aidinattar/RelazioneCatenaElettronica/relazione.pdf

# Catena elettronica

Docente: dott. Garfagnini, dott. Lunardon Gruppo 14

Anno accademico 2019/20

- Aidin Attar - 1170698 - aidin.attar@studenti.unipd.it
- Ema Baci - 1171107 – ema.baci@studenti.unipd.it
- Alessandro Bianchetti – 1162147 – alessandro.bianchetti@studenti.unipd.it

SCOPO DELL’ESPERIENZA: STUDIO DELLA CATENA ELETTRONICA COME MODELLO DI RI-VELATORE PER RADIAZIONE IONIZZANTE

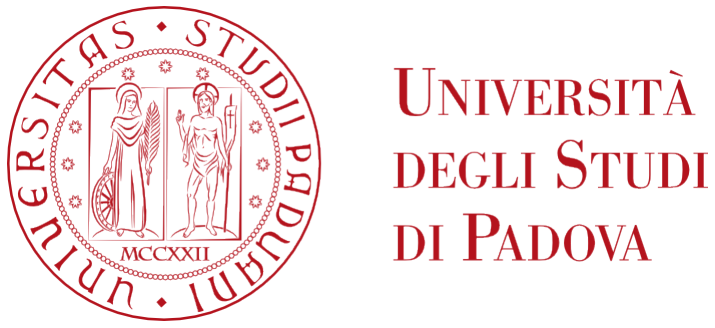
[picture p2: figure]

Descrizione dell’apparato

La seguente esperienza è stata svolta sul banco di lavoro 1. L’apparato di misura consiste di un oscilloscopio digitale Tektronix TBS 1102B EDU, un generatore di funzioni Tektronix AFG 1022, un alimentatore di tensione continua stabilizzato, due multimetri digitali (Metrix 32292 e Agilent U1230) e una scheda Arduino Due. Si è inoltre fatto uso di due integrati TL082C contenenti in tutto 4 amplificatori operazionali.
I circuiti studiati sono stati costruiti sulla basetta millefori alimentando gli amplificatori operazionali come nello schema riportato in Figura 1
I valori misurati di resistenze e capacità utilizzate verranno riportati in seguito, mentre la procedura per identificare le incertezze è descritta in appendice.
Infine si è fatto uso di due sonde con fattore di attenuazione 10x precedentemente compensate per la visualizzazione del segnale nei due canali dell’oscilloscopio.
Per l’analisi dati sono stati utilizzati programmi scritti in c++, root ed Excel.

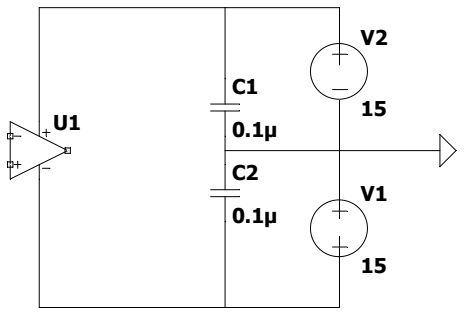
[picture p3: figure]

Figura 1: schema per l’alimentazione dell’operazionale

## 1 Preamplificatore di carica

### 1.1 Breve discussione del circuito

Lo scopo dell’esperienza completa è costruire un circuito che possa rilevare piccoli segnali, amplificarli tanto da poterli processare con più facilità e poi amplificarli ulteriormente per offrirli allo sperimentatore. Il primo passo della realizzazione di tale catena elettronica è il circuito preamplificatore. Qui il generatore di funzioni è utilizzato proprio per simulare piccoli segnali di cui sopra analoghi a quelli che proverrebbero tipicamente da esperienze di spettrocopia: si forniscono dunque in ingresso impulsi di tensione (PULSE) come quelli che produrrebbe il passaggio di una radiazione ionizzante in un volume di gas. Si è dunque costruito il circuito come in Figura 2

La funzione di trasferimento è data, nel formalismo di Laplace, da

H(s) = −

Rpre

Rin

1

1 + sRpreCpre

(1)

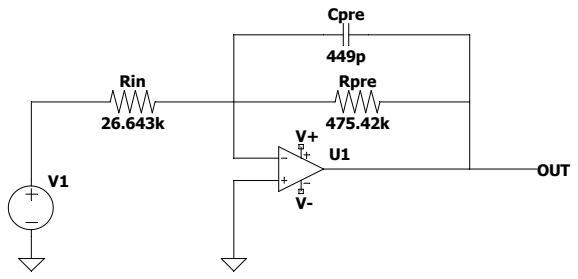
[picture p4: figure]
Cpre; 449p Rpre; Rin; OUT

Figura 2: circuito amplificatore di carica

in cui possiamo effettuare la sostituzione s ←→ iω per riprodurre la soluzione stazionaria. Considerando poi solamente il modulo, e definendo il tempo caratteristico τpre = RpreCpre, avremo

H(ω) = Rpre

Rin

1
q
1 + ω²τ

2
pre

(2)

Si osserva inoltre che inserendo nella formula 1 la trasformata di Laplace dell’impulso di tensione, pari a Vin/s, si otterrà in uscita, antitrasformando opportunamente, un segnale esponenziale corrispondente a

V

pulse
pre (t) = −

Rpre

Rin

Vin(1 − e

− t
τpre ) | (3)

Quest’ultima è valida finché dura l’impulso di tensione: essendo Tpulse << τpre, potremo considerare l’espansione in serie di Taylor della 3, ottenendo una discesa lineare. Tale discesa lineare si interromperà all’esaurirsi dell’ impulso in ingresso, lasciando posto alla formula della scarica del condensatore Cpre, caricato proprio dallo stesso impulso. Ne risulta un grafico che ha un picco negativo V

max
pre in
corrispondenza di t = Tpulse, per poi risalire con la curva esponenziale dettata da

V

RC
pre (t) = V

max
pre e

− t
τpre . | (4)

### 1.2 Discussione dati

Si precisa che sono stati suggeriti dei valori per i parametri del circuito τpre,th = 220µs e Cpre = 450 pF, con Rpre calcolato di conseguenza. Pertanto i valori misurati con il multimetro Metrix 32292 sono

Rpre = (475.4 ± 0.2)kΩ σ% = 0.04%
Cpre = (149 ± 14)pF σ% = 3.1% τpre,th = (213 ± 7)µs σ% = 3.1%

Si è dunque impostato un impulso della durata di Tpulse = 2µs: sapendo inoltre che la carica da iniettare corrispondeva a Qth
in = 80 pC e che la resistenza di ingresso scelta misurava Rin = (26.64 ± 0.01) kΩ (σ% = 0.04%), si è selezionata l’altezza Vin dell’impulso in modo che fosse soddisfatta la relazione
Qin =

Vin

Rin

Tpulse. | (5)

Ne si è ricavato V

th
in = 1.06V. Per controllare la correttezza del circuito si è misurato il picco V

max
pre , dato, utilizzando
l’approssimazione della 3, da

V

max
pre = −

Rpre

Rin

Vin

Tpulse

τpre

= −

Qin

Cpre

(6)

da cui, inserendo il valore misurato V

th
in = (1.02 ± 0.02)V,
si ricava V

max
pre,th = (−170±6)mV. Invece dalla misura si ottiene V

max
pre,sper = (−176±4)mV, per cui λ = 0.76 e lo scostamento percentuale è = 3.2%, ossia il valore misurato è ottimamente compatibile con quello atteso.
Si è inoltre la verificata la linearità tra Qin e V

max
pre de-
scritta da 6 variando la durata dell’impulso in ingresso e quindi la carica iniettata nel circuito secondo 5. Si riportano quindi in grafico i punti, la retta interpolante e i principali

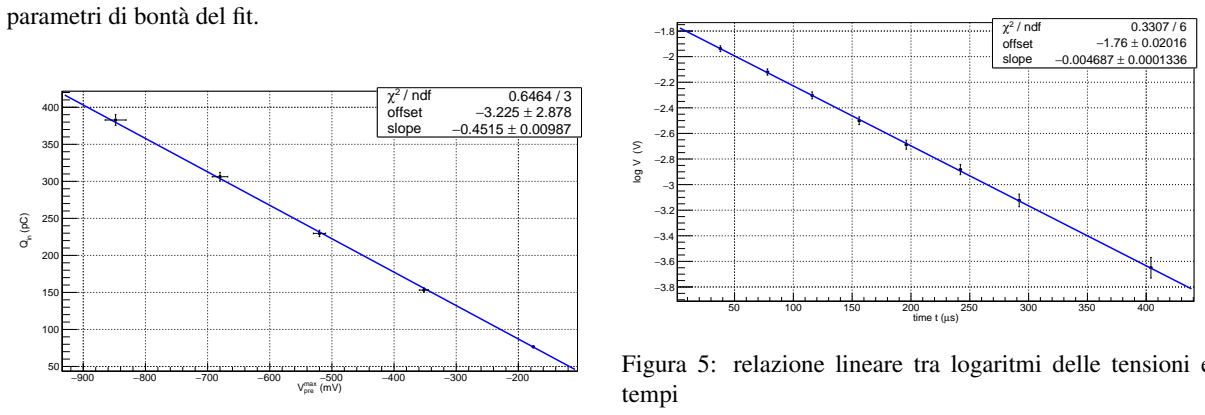
[picture p5: figure]
parametri di bontà del fit.; (mV) max Vpre; time t (µs); log V (V); tempi

| / ndf ² χ / ndf ² χ | 0.6464 / 3 0.6464 / 3
offset offset slope slope | | −3.225 ± 2.878 −3.225 ± 2.878 −0.4515 ± 0.00987 −0.4515 ± 0.00987

Figura 3: carica iniettata e picco di tensione in uscita

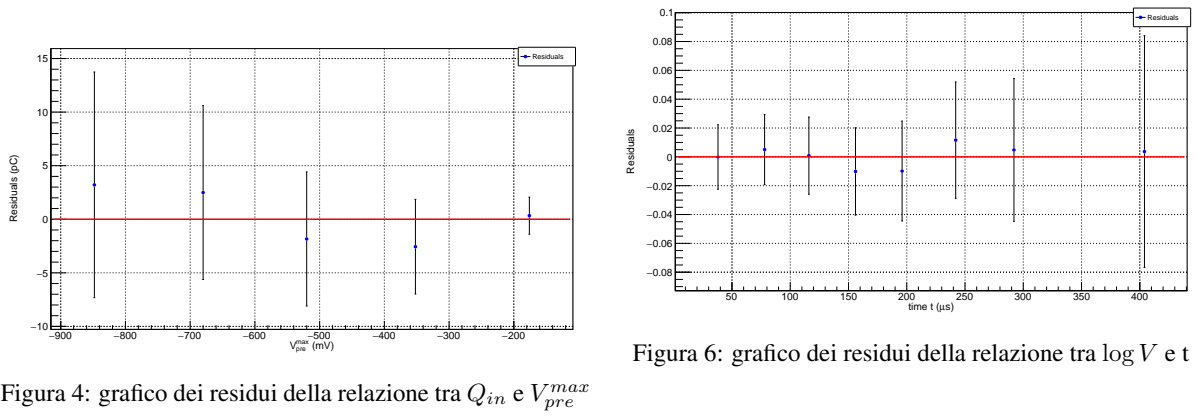
[picture p6: figure]
(mV) max Vpre; Residuals (pC); Residuals; max pre; time t (µs)

Figura 4: grafico dei residui della relazione tra Qin e V

σy,post | χ
| (2) | λχ | ρ | t
3.0 pC | 0.65 | 0.96 | -0.9998 | -109.14

Tabella 1: parametri di verifica della bontà del fit

Si specifica che il fit è stato effettuato utilizzando gli errori di entrambe le coordinate, poichè nessuno dei due errori relativi è risultato trascurabile rispetto all’altro. Gli estimatori danno tutti risposta positiva, quindi possiamo concludere che la relazione lineare è ben verificata. Inoltre dal valore di pendenza, considerando la legge lineare 6, è possibile ottenere una stima sperimentale della capacità

Cpre, da confrontare con il valore misurato. Si ricava quindi Cpre,sper = (452 ± 10)pF, che ha λ = 0.15 rispetto al valore misurato.
Inoltre dallo studio della 4, e in particolare della sua linearizzazione logaritmica, è possibile ricavare una stima sperimentale di τpre. Infatti applicando il logaritmo naturale si ottiene

log V (t) = log V

max
pre −

t

τpre

(7)

per cui si trova una relazione lineare tra log V (t) e t, da cui τpre=-1/b con b slope del fit. Si riporta il grafico di tempi e logaritmi delle tensioni, interpolati linearmente, e il relativo grafico dei residui

/ ndf ² χ / ndf ² χ | | 0.3307 / 6 0.3307 / 6
offset offset | | −1.76 ± 0.02016 −1.76 ± 0.02016
slope slope | −0.004687 ± 0.0001336 −0.004687 ± 0.0001336

Figura 5: relazione lineare tra logaritmi delle tensioni e

Figura 6: grafico dei residui della relazione tra log V e t

σy,post | χ
| (2) | λχ | ρ | t
0.008 V | 0.33 | 1.64 | -0.99991 | -189.59

Tabella 2: parametri di verifica della bontà del fit

Si osserva la buona riuscita del fit, che verifica la scarica RC del circuito al termine dell’impulso. Tuttavia è possibile notare una forte sovrastima degli errori sia visivamente osservando il grafico dei residui in Figura 6, sia osservando il valore molto basso di χ

| | (2)
Dal valore della pendenza, come anticipato prima, ricaviamo una stima di τ
| | sper
pre . A scopo di controllo, è inoltre possibile ottenere una valutazione di V
| | | | max
pre | usando il
parametro di offset a sapendo V
| | | max
pre | = e

a
| | | | . Si riportano

quindi i due valori calcolati con i loro errori calcolati per propagazione.

τ

sper
pre = (213 ± 6)µs σ% = 2.9%

V

max
pre = (−172 ± 3)mV σ% = 2.0%

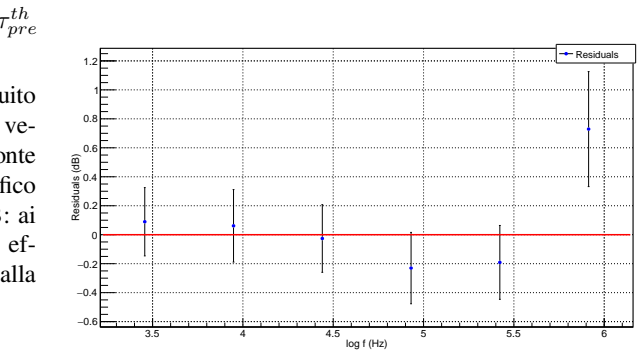
[picture p7: figure]
th pre; log f (Hz); Residuals (dB)

che risultano ottimamente compatibili con i valori attesi τ e V

max
pre,th, in quanto λτ = 0.01 e λV = 0.2.

Si è infine effettuato uno studio in frequenza del circuito con lo scopo di verificare la 2, variando la frequenza e verificando il variare del modulo dell’amplificazione di fronte a un ingresso sinusoidale. Si riporta in particolare il grafico di Bode che raffigura frequenza e amplificazione in dB: ai punti sperimentali si è affiancata anche la simulazione effettuata su LTspice e il modello teorico rappresentato dalla 2.

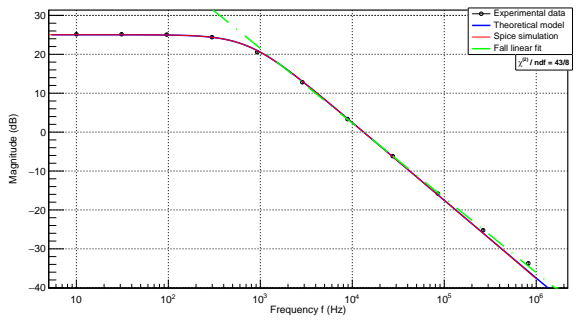
[picture p8: figure]
Frequency f (Hz); Magnitude (dB); / ndf = 43/8 ⁽²⁾ χ

Experimental data Theoretical model Spice simulation Fall linear fit

Figura 7: grafico di Bode del circuito preamplificatore

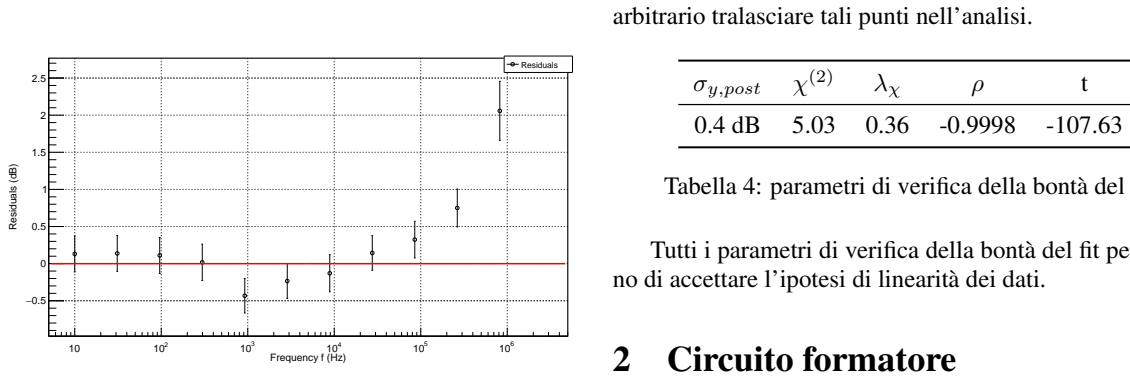
[picture p9: figure]
Frequency f (Hz); Residuals (dB); Residuals; arbitrario tralasciare tali punti nell’analisi.; σy,post; 2 Circuito formatore

Figura 8: residui del grafico di Bode

Si osserva che i dati sono rappresentati ottimamente dal modello teorico per basse frequenze, mentre per alte frequenze tendono a discostarsi, anche in modo significativo da esso. Si osserva quindi un valore di χ

(2) ≈ 43 del tutto
incompatibile con il suo valore di aspettazione (gdl = 8). La natura di tali problematiche è da ricercarsi in effetti trascurati, quali capacità parassite della breadboard utilizzata o altri fenomeni che causano la non idealità dell’esperimento.
Come si può notare in Figura 7 si è effettuato anche un fit lineare della discesa, per verificare che la slope sia effettivamente compatibile con il valore atteso di −20dB/decade. Si ottengono dunque i seguenti parametri di interpolazione:
| a±σa | b±σb
| (dB) | (dB/decade)
discesa | 79.1±0.6 | -19.2±0.1

Tabella 3: parametri di interpolazione lineare della discesa

Residuals Figura 9: residui dell’interpolazione lineare della discesa

Si nota che il valore di slope non è di fatto compatibile con il valore atteso: questa problematica potrebbe essere dovuta a una sottostima degli errori. In alternativa, è possibile che gli ultimi dati possano avere qualche bias: infatti escludendo questi punti dal fit si ottiene un valore di pendenza compatibile con il valore di aspettazione. Si evita tuttavia di scartare dati: si otterrebbe un set eccessivamente ristretto e soprattutto non si conosce la natura di questo bias (potrebbe essere dovuto, come già detto, a capacità parassite non considerate nello studio), sarebbe quindi del tutto

Tabella 4: parametri di verifica della bontà del fit

Tutti i parametri di verifica della bontà del fit permettono di accettare l’ipotesi di linearità dei dati.

### 2.1 Shaper base CR-RC

### 2.1.1 Breve discussione del circuito

Il secondo passo per la costruzione della catena elettronica consiste invece nella costruzione del circuito formatore il cui schema è riportato in Figura 10, che plasmi il segnale fornendo tipicamente un profilo gaussiano.

Si osserva che il circuito è costruito tramite due stadi RC e CR, disaccoppiati tramite un buffer costruito utilizzando il secondo opamp presente nel TL082.
Si specifica inoltre che i valori di C

(1)
sh ≈ C

(2)
sh e R

(1)
sh ≈
R

(2)
sh sono stati scelti in modo da ottenere il valore di τsh indicato nel logbook. Tuttavia, a causa di un cambio di

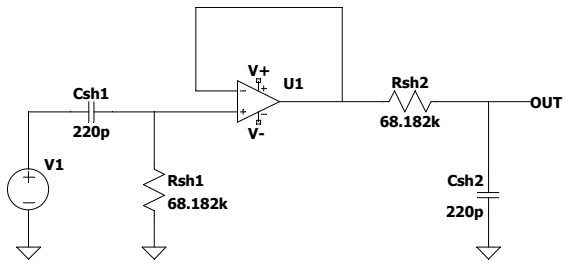
[picture p10: figure]
Csh1; Csh2; Rsh1 68.182k; Rsh2; OUT

Figura 10: circuito formatore

combinazione in corso d’opera per problemi sorti durante la prima giornata di esperienza, τsh e Csh con cui si è lavorato sono sì quelli della nuova combinazione, ma le altre grandezze in gioco sono rimaste quelle della combinazione originale (Cpre,th = 330 pF, τpre = 220 µs). Si è utilizzata quindi una capacità di 220 pF e una costante di tempo caratteristica τsh di 15 µs che in realtà non sono associati ai parametri usati del preamplificatore in nessuna combinazione.
Trattando il circuito con Laplace e considerando la fase stazionaria, si ottiene che la funzione di trasferimento in funzione di ω è la seguente:

H(ω) = ωτ
1 + ω²τ

2

(8)

In particolare, inserendo in ingresso un’onda quadra tra 0 e V0 si ottiene la funzione Vout(t) facendo l’antitrasformata dal dominio delle frequenze:

Vout(t) = −

V0
τ

t · e

− t
τ | (9)

### 2.1.2 Discussione dei dati

Si è nuovamente impostata sul generatore di funzioni un’onda quadra di frequenza di 100 Hz e ampiezza misurata pari a V0 = (992 ± 15)mV in modo che simuli il comportamento di un preamplificatore ideale che mantenga il segnale alto per un tempo indefinito.
Sapendo che τth = R

(1)
sh C

(1)
sh = R

(2)
sh C

(2)
sh = 15µs si
sono scelti e misurati i seguenti valori:

R

(1)
sh = (68.31 ± 0.03)kΩ σ% = 0.04%

R

(2)
sh = (68.075 ± 0.03)kΩ σ% = 0.04%

C

(1)
sh = (234 ± 9)pF σ% = 4%

C

(2)
sh = (234 ± 9)pF σ% = 4%

dove l’errore è stato calcolato secondo quanto scritto in appendice.
Mediante i cursori si è quindi misurato il valore massimo (in valore assoluto) V

max
sh = (346 ± 6)mV e il tempo corrispondente τ

max
sh = (16 ± 1)µ s.
Si è poi verificata la correttezza del trasferimento immettendo nel circuito un’onda quadra di ampiezza 1V e misurando un set di 10 punti della curva in uscita, indicata dal modello in 9. In particolare però per l’identificazione della curva teorica si è scelto di non utilizzare il τ

sper
sh ma bensì di
sfruttarlo come parametro per applicare il metodo del minimo χ

(2), ossia vagliare i valori del χ

(2) rispetto ai dati sperimentali al variare di τsh e quindi della curva teorica e poi scegliere il tempo caratteristico per cui l’estimatore risulta avere un minimo. La scelta del minimo è stata effettuata tramite un fit parabolico in prossimità della convessità, e calcolando l’ascissa del vertice della parabola. L’errore di τsh è dato dalla semidispersione ottenuta facendo riferimento all’intervallo [τ+; τ−] tali per cui χ

(2)
± = χ

(2)
min + 1.

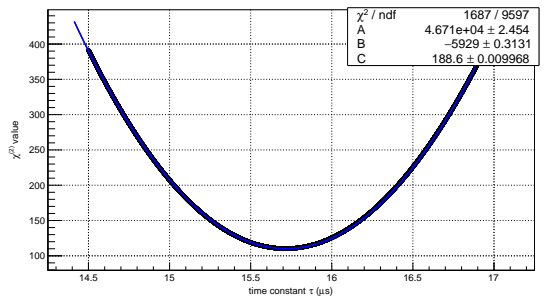
[picture p11: figure]
time constant τ (µs); value (2)

/ ndf ² χ / ndf ² χ A A B B | 1687 / 9597 1687 / 9597 4.671e+04 ± 2.454 4.671e+04 ± 2.454 −5929 ± 0.3131 −5929 ± 0.3131
C | 188.6 ± 0.009968 Figura 11: andamento di χ
(2) al variare di τsh

Da cui si sceglie τsh = (15.72 ± 0.07)µs. Tuttavia si osserva che il valore di χ

(2) ≈ 110 corrispondente è tutt’altro che confortante considerando il numero limitato di gradi di libertà. I grafici seguenti mostrano tale problematica:

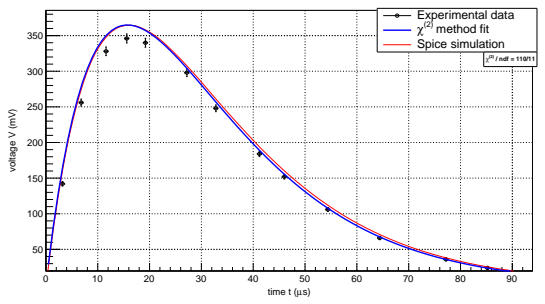
[picture p12: figure]
time t (µs); voltage V (mV); Spice simulation; / ndf = 110/11 ⁽²⁾ χ

| Experimental data method fit ⁽²⁾ χ

Figura 12: risposta del circuito formatore a un’onda quadrata in ingresso

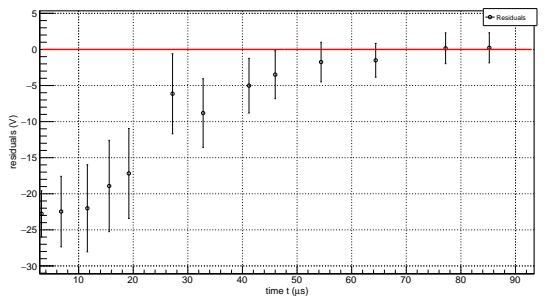
[picture p13: figure]
time t (µs); residuals (V); Residuals

Figura 13: residui della risposta dello shaper a un’onda quadra

Si nota che i dati non sono compatibili con il modello teorico, in quanto pur riproducendone l’andamento risultano sensibilmente staccati, in particolare in prossimità del picco. La forma 9 ha massimo in V0/e, ossia il picco è proporzionale all’altezza dell’impulso inserito, per cui si dovrebbe avere V

max
sh,th = (365 ± 5)mV , mentre si è misurato V

max
sh = (346 ± 6)mV . La compatibilità è λ = 2.3, accettabile, ma comunque pessima. Da una parte abbiamo quindi il cattivo χ
| (2), dall’altra una compatibilità accettabile tra i
due picchi: si potrebbe dunque sospettare una certa sottostima degli errori, che però non sembra sufficiente a spiegare un tale distacco dei dati dal modello, che sembrerebbe sistematico, in quanto i dati tendono a rimanere sempre al di sotto della curva teorica.
| Come anticipato, il valore di χ
(2) ottenuto porta a dover rifiutare il fit. Dal grafico dei residui si osserva la tendenza per la quale ai tempi iniziali la curva risulta completamente inadatta, mentre sulla coda descrive bene i dati.
| Osservando anche la curva ottenuta dalla simulazione
spice si nota che essa risulta molto fedele alla curva ottenuta con il fit, quindi il problema sembrerebbe essere sui dati.
| Tale problematica potrebbe essere riconducibile ad un
errore umano, dovuto a impostazioni sbagliate nell’onda in ingresso, come ad esempio l’ampiezza dell’onda, o in alternativa a qualche bias dovuta ancora alla non idealità del circuito.
| Si è infine nuovamente studiato il comportamento del
circuito al variare della frequenza. Si è ottenuto il seguente grafico di Bode (Figura 14), al fine di ottenere un confronto immediato sono plottate sovrapposte la curva teorica relativa ai dati sperimentali ed il fit dei dati ottenuti mediante la simulazione di LTspice:

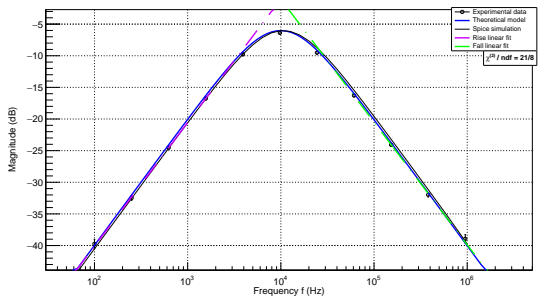
[picture p14: figure]
Frequency f (Hz); Magnitude (dB); Experimental data Theoretical model; / ndf = 21/8 ⁽²⁾ χ

| Spice simulation Rise linear fit Fall linear fit
Figura 14: grafico di Bode del circuito formatore 10 | 2 10 | 3 10 | 4 10 | 5 10 | 6 10

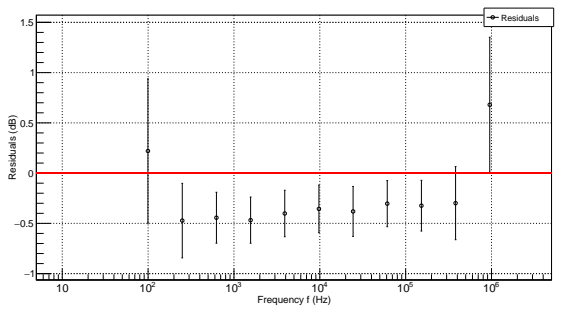
[picture p15: figure]
Frequency f (Hz); Residuals (dB); Residuals

Figura 15: residui del grafico di Bode

Si osserva il diverso comportamento dello shaper base, che opera come derivatore per frequenze basse e come integratore a frequenze alte.
Il valore di χ
(2) risulta compatibile con il suo valore di aspettazione, in accordo con la Tabella 14. Tuttavia si nota in Figura 15 una certa sistematicità: la curva tende a rimanere sempre sopra ai dati.
Come si osserva in Figura 14 si sono effettuati i fit della salita e della discesa, per la verifica della consistenza delle pendenze.
| a±σa | b±σb
| (dB) | (dB/decade)
salita | -79±1 | 19.5±0.4
discesa | 77±2 | -19.4±0.4

Tabella 5: parametri di interpolazione della salita e della discesa

4.8 | 5 | 5.2 | 5.4 | 5.6 | 5.8 | 6
| | | log f (Hz)

−0.6

−0.4

−0.2

0

0.2

0.4

0.6

0.8

1

1.2

Residuals (dB)

Residuals

(a) Residui fit della discesa
2 | 2.2 | 2.4 | 2.6 | 2.8 | 3 | 3.2
| | | log f (Hz)

−0.6

−0.4

−0.2

0

0.2

0.4

0.6

0.8

1

1.2

Residuals (dB)

Residuals

(b) Residui fit della salita

Figura 16: residui per i fit lineari dello shaper

| σy,post | χ
| | (2) | λχ | ρ | t
discesa | 0.4 dB | 1.01 | 0.49 | -0.9996 | -51.23
salita | 0.3 dB | 0.44 | 0.78 | 0.9998 | 76.28

Tabella 6: parametri di verifica della bontà del fit

Si osserva che i valori di slope osservati sono compatibili con i valori attesi e i parametri di verifica della bontà del fit permettono tutti di accettare l’ipotesi di andamento lineare.

### 2.2 Shaper compensato

### 2.2.1 Breve discussione del circuito

Si è proceduto inserendo come segnale in ingresso dello shaper il segnale di uscita del preamplificatore. Subentra quindi il problema di dover compensare l’effetto del pole-zero: infatti, se si considera in ingresso un segnale del tipo

Vin(t) = V0e

| | | − t
τpre

si ottiene la seguente trasformata di Laplace:

Vin(s) = | V o
| | | s +

1

| | | τpre | | (10)

che presenta un polo in −

| | 1 τpre
, responsabile dell’undershoot del segnale.
Si osserva però che il segnale in uscita dal primo stadio (CR) del formatore con una tensione in ingresso a gradino è descritto dalla seguente formula: Vout(s)
| | | | CR = | V0 s+ 1 τsh
; si

vuole quindi modificare il circuito in modo che all’ingresso del buffer arrivi un segnale che segua questo stesso andamento. Si è quindi inserita una resistenza Rpz in parallelo

a C

(1)
sh e si è studiato l’andamento di Vout(s)

CR di questo
nuovo circuito mediante la trasformata di Laplace:

Vout(s)

CR =

V0
s +

1
τpre

·

s +

1
τpz
s +

1
τk

(11)

dove τpz = C

(1)
sh Rpz, τk = C

(1)
sh Rk e Rk è il parallelo di R

(1)
sh e Rpz; l’effetto del polo del preamplificatore è quindi annullato con quello dello zero del CR compensato nel caso in cui τsh = τpz . Regolando quindi opportunamente tale valore si compensa l’effetto pole-zero; si è quindi scelto

Rpz =

τpre

C

(1)
sh
Si riporta quindi di seguito lo schema del circuito dello shaper compensato:

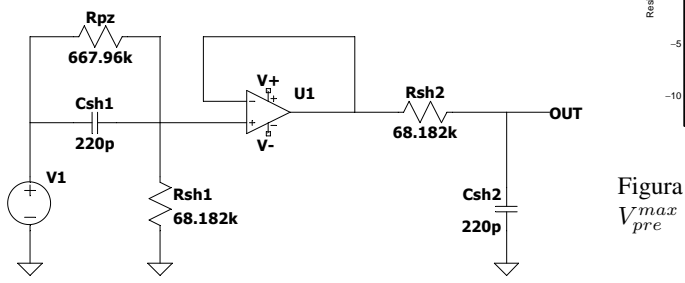
[picture p16: figure]
Csh1; Csh2; Rsh1 68.182k; Rsh2; Rpz; OUT; max pre

Figura 17: circuito formatore con compensazione

dove V1 è il segnale in uscita dal preamplificatore. Studiando infine la funzione di trasferimento dell’intero circuito mediante la trasformata di Laplace e passando al dominio delle frequenze con la sostituzione s −→ iω si ottiene:

|H(ω)| =

### vuut

1
1 + (ωτ )

2

·

(R

(1)
sh )

2 + (Rpzωτ )

2
(R

(1)
sh + Rpz)

2 + (Rpzωτ )

2
(12)

### 2.2.2 Discussione dei dati

Si è osservato che senza utilizzare lo shaper base per un segnale esponenziale come quello fornito dal preamplificatore si ottiene il fenomeno dell’undershoot: infatti unendo preamplificatore e shaper si è misurato Vsh,undershoot = (346 ± 6)mV (l’undershoot è positivo poichè il segnale è ribaltato a causa della natura invertente del preamplificatore). Inserendo invece la resistenza Rpz = (668.0 ± 3)kΩ si vede che l’effetto di undershoot sparisce e il segnale si adagia correttamente sullo zero delle tensioni.
Con il circuito correttamente compensato, si è verificato che la relazione tra carica iniettata e tensione in uscita fosse lineare, variando la durata dell’impulso in ingresso e acquisendo i picchi delle forme d’onda semigaussiane in uscita dallo shaper.

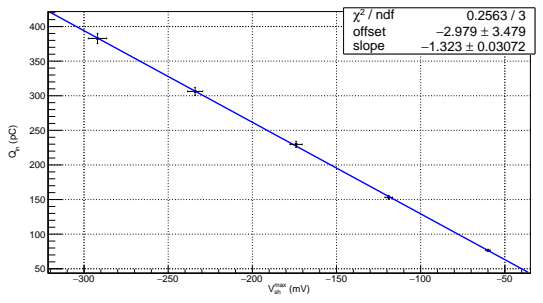
[picture p17: figure]
(mV) max Vsh

/ ndf ² χ / ndf ² χ | 0.2563 / 3 0.2563 / 3
offset offset slope slope | −2.979 ± 3.479 −2.979 ± 3.479 −1.323 ± 0.03072 −1.323 ± 0.03072

Figura 18: carica iniettata e picco di tensione in uscita

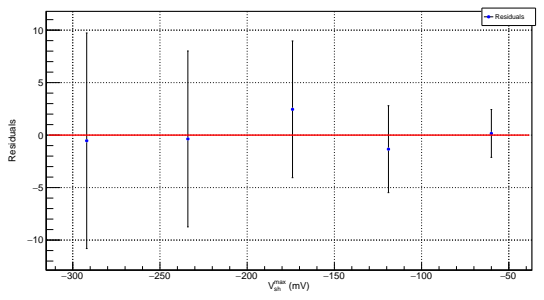
[picture p18: figure]
(mV) max Vsh; Residuals

Figura 19: grafico dei residui della relazione tra Qin e

σy,post | χ
| (2) | λχ | ρ | t
1.7 V | 0.26 | 1.12 | -0.99993 | -146.28

Tabella 7: parametri di verifica della bontà del fit

I parametri confermano la buona riuscita del fit lineare e dunque costituiscono la prova della relazione lineare che intercorre tra carica iniettata e uscita dello shaper.

## 3 Circuito amplificatore invertente

### 3.1 Descrizione del circuito

Unendo il circuto preamplificatore con il circuito formatore otteniamo un segnale correttamente processato ma negativo e dunque non adatto all’acquisizione da parte di Arduino. Pertanto implementiamo un circuito amplificatore invertente, in particolare un amplificatore di strumentazione. Tale apparato consiste di un opamp alimentato nell’ingresso invertente, capace dunque di cambiare segno al segnale, preceduto da un buffer, che ha la funzione di garantire un’alta impedenza di ingresso: infatti con il solo amplificatore invertente il segnale cadrebbe sulla resistenza R1a, mentre grazie alla presenza dell’inseguitore di tensione l’impedenza di ingresso è l’impedenza interna dell’opamp U1, che si può considerare infinita.

U4

R3a

5k

R4a

7.5k

R1a

5k

R2a

13k

U3

IN shaper

V+

V- | V+
| V-

Figura 20: circuito amplificatore invertente

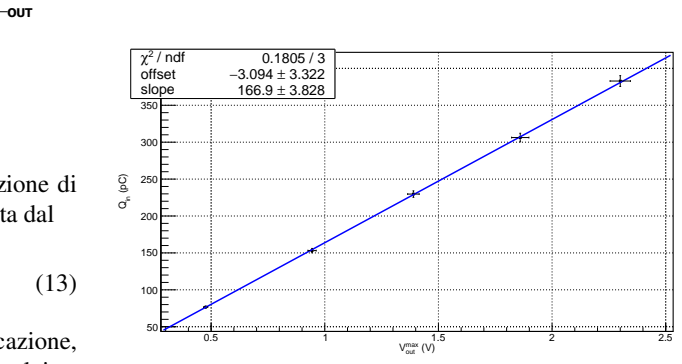
[picture p19: figure]
OUT; (V) max Vout

Da semplici considerazioni si trova che la funzione di trasferimento è costante rispetto alla frequenza e data dal

H = −

R2a

R1a

R4a

R3a

+ 1

Innanzitutto si è predisposta la corretta amplificazione, per poter visualizzare segnali dell’ordine di qualche volt immettendo nel circuito impulsi della durata di qualche unità di µs: si deve dunque considerare la quantità di carica Qin scegliendo un impulso di durata 10µs in ingresso, misurare l’uscita dell’apparato preamplificatore + shaper Vsh e si calcola l’opportuno apparato resistivo in modo da generare in uscita un segnale di approssimativamente 2 V, cioè imporre, usando la 13, H = 2 V/Vsh, dove Vsh corrisponde al picco in uscita dal formatore.
Variando poi la durata dell’impulso di Vin e quindi la carica Qin è verificata la relazione lineare che ancora intercorre con il Vout della catena completa.
Introducendo poi segnali sinusoidali in ingresso di frequenza variabile si è effettuato un grafico di Bode per verificare la risposta in frequenza della catena elettronica. Combinando quindi le funzioni di trasferimento del circuito preamplificatore 2, dello shaper compensato 12 e dell’amplificatore di strumentazione 13, si ottiene la funzione di trasferimento totale.

|H(ω)| =

Rpre

Rin

1
q
1 + ω²τ

2
pre

·

·

R²
sh + ω

2R²
pzτ

2
sh
(Rsh + Rpz)

2 + ω²R²
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
(14)

### 3.2 Discussione dati

Utilizzando quindi il circuito fin qui costruito e iniettando la Vin di cui sopra si trova Vsh = (−282 ± 5)mV , pertanto Hth ≈ 7. Si può dunque scegliere le resistenze di conseguenza, in particolare:

R1a = (15.003 ± 0.007)kΩ σ% = 0.05% R2a = (32.57 ± 0.01)kΩ σ% = 0.04% R1a = (14.999 ± 0.007)kΩ σ% = 0.05% R1a = (32.60 ± 0.01)kΩ σ% = 0.04% da cui Hsper = −6.88. Realizzato dunque il circuito si è proceduto con l’acquisizione di Vout al variare dell’impulso in ingresso, di cui si riportano di seguito dati e fit lineare.

400 offset offset slope slope | / ndf ² χ / ndf ² χ | 0.1805 / 3 0.1805 / 3
| | −3.094 ± 3.322 −3.094 ± 3.322 166.9 ± 3.828 166.9 ± 3.828

Figura 21: Relazione lineare tra carica iniettata e uscita della catena

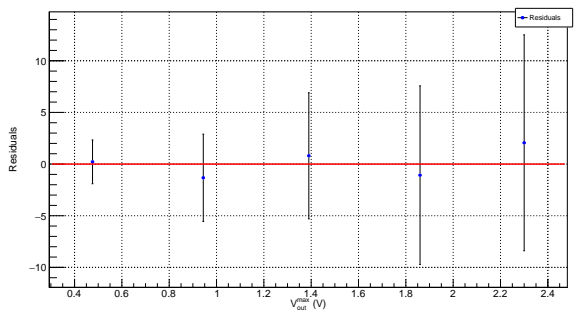
[picture p20: figure]
(V) max Vout; Residuals

Figura 22: Grafico dei residui della relazione tra Qin e Vout

σy,post | χ
| (2) | λχ | ρ | t
1.6 pC | 0.18 | 1.15 | 0.99994 | 167.63

Tabella 8: parametri di verifica della bontà del fit

Si osserva che i parametri di bontà del fit sono buoni, a testimonianza di una ben verificata relazione Successivamente si presenta il grafico di Bode della catena, in cui sono raffigurati i dati sperimentali, i dati simulati su LTspice e il modello teorico espresso dalla 14.

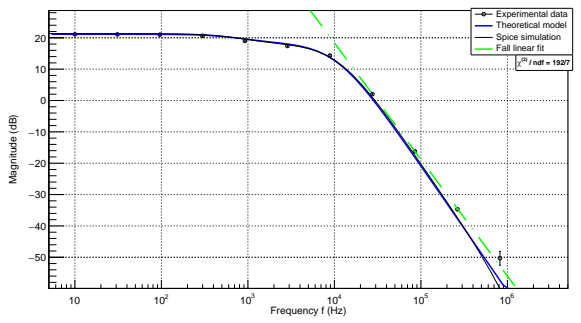
[picture p21: figure]
Frequency f (Hz); Magnitude (dB); Fall linear fit; / ndf = 192/7 ⁽²⁾ χ

Experimental data Theoretical model Spice simulation

Figura 23: grafico di Bode della risposta in frequenza della catena elettronica

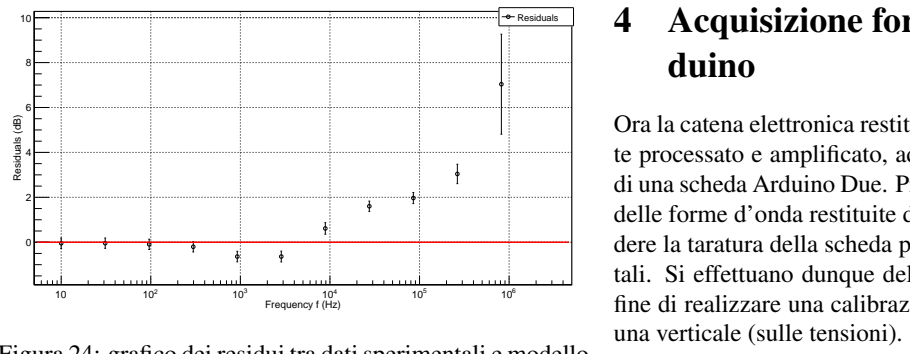
[picture p22: figure]
Frequency f (Hz); 10Residuals ⁽dB⁾; Residuals; duino; una verticale (sulle tensioni).

Figura 24: grafico dei residui tra dati sperimentali e modello

Si può osservare una forte incompatibilità dei dati con il modello teorico: il valore di χ

(2) risulta assolutamente incompatibile con il suo valore di aspettazione. Come si può osservare nel grafico dei residui, le problematiche sono sulle alte frequenze: questo fenomeno, alla luce dei problemi su preamplificatore e shaper in cui la curva teorica aveva problemi sulle alte frequenze, era preventivabile: infatti la funzione di trasferimento della catena completa altro non è che il prodotto delle funzioni delle sue singole parti, quindi tali problematiche si amplificano.
Si è infine effettuato un fit della discesa per verificare che la pendenza sia compatibile con -40 dB/decade.
| a±σa | b±σb
| (dB) | (dB/decade)
discesa | 167±2 | -37.2±0.5

Tabella 9: parametri di interpolazione lineare della discesa

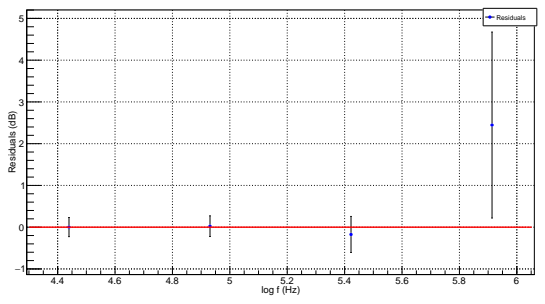
[picture p23: figure]
log f (Hz); Residuals (dB); Residuals

Figura 25: grafico dei residui del fit della discesa della catena

σy,post | χ
| (2) | λχ | ρ | t
1.7 dB | 1.38 | 1.12 | -0.9993 | -37.85

Tabella 10: parametri di verifica della bontà del fit

Si nota ancora una volta che la pendenza non è compatibile con il valore atteso (λ ≈ 5.6). Il fatto, alla luce delle analisi precedenti, non stupisce: i problemi incontrati nelle precedenti sezioni si ripercuotono fin qui.

## 4 Acquisizione forme d’onda con Ar-

Ora la catena elettronica restituisce un segnale correttamente processato e amplificato, adatto alla rivelazione da parte di una scheda Arduino Due. Prima di iniziare l’acquisizione delle forme d’onda restituite dal circuito, occorre comprendere la taratura della scheda per poi gestire i dati sperimentali. Si effettuano dunque delle acquisizioni preliminari al fine di realizzare una calibrazione orizzontale (sui tempi) e

In particolare per la calibrazione orizzontale si sono utilizzate onde sinusoidali di diversa frequenza (e dunque periodo), confrontando il periodo T con il conteggio dei punti nell’acquisizione secondo la formula T = a+b·ch, dove ch rappresenta il periodo in counts stimato attraverso un algoritmo che individua gli zeri nella forma sinusoidale traslata in modo da essere simmetrica rispetto all’asse delle ascisse. Per brevità si riporta, per entrambe le calibrazioni, un solo set di dati.

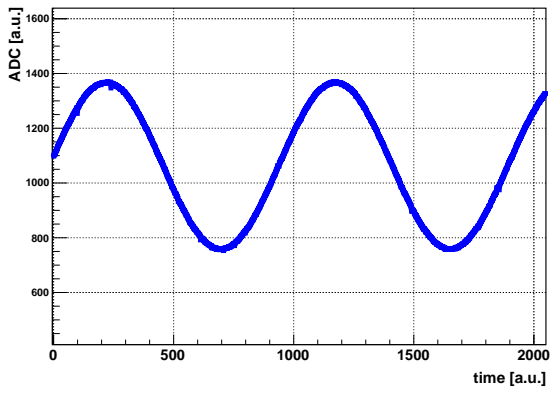
[picture p24: figure]
time [a.u.]; ADC [a.u.]

Figura 26: acquisizione forma sinusoidale per frequenza 1 kHz

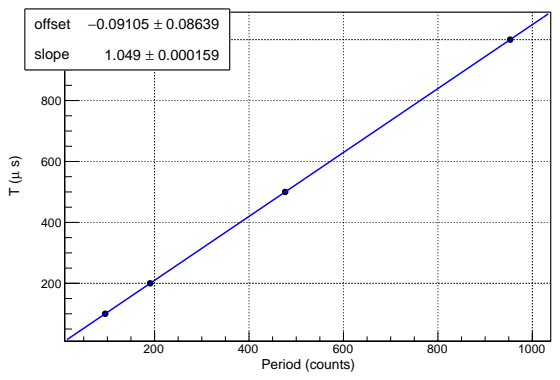
[picture p25: figure]
Period (counts)

offset −0.09105 ± 0.08639 offset −0.09105 ± 0.08639 1000 slope slope

Figura 27: calibrazione temporale

Ne si ricava che il software acquisisce un punto in ogni intervallo pari alla slope b, ossia ogni (1.0490±0.0002)µs. Inoltre, come atteso il valore di offset risulta compatibile con lo 0.

Per la calibrazione verticale sulle tensioni si sono immesse nel circuito onde quadrate tra 0 e una tensione di altezza variabile, per poi effettuare nuovamente un fit lineare del tipo V = a + b · ch, dove ch stavolta indica l’altezza dei plateau della tensione in conteggi: il parametro b fornirà il fattore di conversione mV/counts, mentre a mostra l’offset aggiunto dalla scheda arduino alla tensione effettiva.

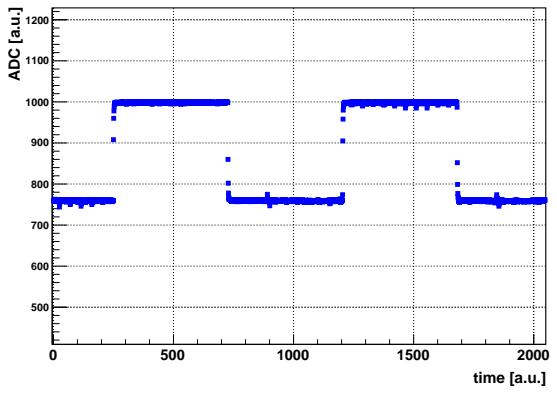
[picture p26: figure]
time [a.u.]; ADC [a.u.]

Figura 28: acquisizione onda quadrata per tensione 200 mV

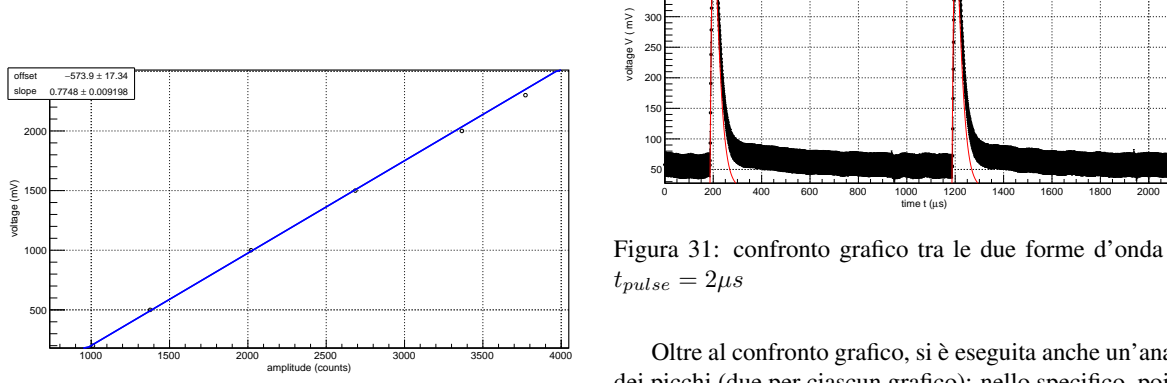
[picture p27: figure]
amplitude (counts); voltage (mV); offset; slope; time t (µs); voltage V ( mV ); tpulse = 2µs

Figura 29: calibrazione verticale

Il valore acquisito da Arduino dovrà quindi essere moltiplicato per la slope (0.775 ± 0.009)mV/counts e traslato dell’offset (−574 ± 17) mV.
L’algoritmo utilizzato in questo caso individua i punti nel plateau superiore e in quello inferiore, e effettua di tali punti la media in modo iterato, escludendo di volta in volta i punti che si discostano dalla media "provvisoria" per più di 3σ.
Effettuata dunque la calibrazione, si è acquisita la forma d’onda in uscita dalla catena elettronica completa con in input il solito impulso di tensione, partendo da una durata di 10µs e diminuendola via via di un’unità ad ogni nuova acquisizione.
Si riportano di seguito, per evitare risultati ripetitivi, solamente due grafici di confronto tra la forma d’onda acquisita dalla scheda e opportunamente convertita con i parametri ottenuti dalla calibrazione e la simulazione ottenuta dal software LTspice; uno dei due grafici si riferisce a un impulso in ingresso di durata 10 µs, l’altro di 2 µs. Per realizzare al meglio tale sovrapposizione grafica, si è dovuto allineare il primo picco della simulazione con quello restituito dalla scheda, poiché Arduino presenta un delay temporale nell’acquisizione che ostacola un corretto allineamento delle due curve.

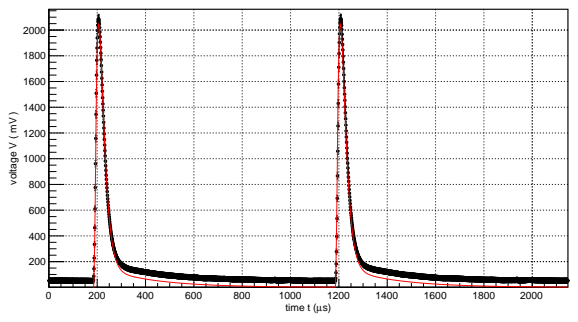
[picture p28: figure]
time t (µs); voltage V ( mV )

Figura 30: confronto grafico tra le due forme d’onda per tpulse = 10µs

300

350

400

450

Figura 31: confronto grafico tra le due forme d’onda per

Oltre al confronto grafico, si è eseguita anche un’analisi dei picchi (due per ciascun grafico): nello specifico, poichè il campionamento risulta sufficientemente fitto, si è preso il massimo acquisito come riferimento. Si è anche calcolata la distanza in σ tra il picco simulato e acquisito, dove σ è l’errore associato al massimo: l’errore sui punti della simulazione è considerato trascurabile, motivo per cui la distanza è valutata solamente in unità di errore dei dati sperimentali. Inoltre, si riporta un controllo asintotico della distanza in forma di compatibilità tra le code delle due forme d’onda, per verificare che queste si adagino correttamente allo zero: in particolare si è scelto un intervallo di tempo appena precedente all’innalzamento del secondo picco e si è eseguita la media pesata tra i valori di tensione associati agli estremi di tale intervallo, con errore fornito dall’errore della media pesata. Nel caso della forma simulata, priva di errore sui punti, si è svolta invece una media semplice attribuendo l’errore della media.
Già da un confronto visivo immediato si intuisce la presenza di un discreto offset tra la simulazione e la forma convertita da Arduino, che si ripercuote anche nella compatibilità tra le coppie di picchi rispettive e nel controllo dello stato asintotico, in cui tale scarto risalta in modo notevole, come esposto nel seguito.
Come anticipato, segue un confronto tra i picchi di tensione, uno tra i tempi del secondo picco (per verificare che persista la corretta periodicità), e infine il controllo della distanza delle tensioni asintotica Vas.
| Arduino | Simulazione | Compatibilità

V

(1)
peak | 2086 ± 36 | 2046.19 | 1.1 σ
(mV)
V

(2)
peak | 2088 ± 36 | 2047.7 | 1.1 σ
(mV)
t

(2)
peak | 1206.9 ± 0.2 | 1205.69 | 6.4 σ
(µs)
Vas | 51 ± 2 | 2.03 ± 0.09 | 24.3 (mV)

Tabella 11: confronto analitico tra le due forme d’onda per tpulse = 10µs

Si precisa che per "compatibilità" si intende "distanza in σ" laddove l’errore sulla simulazione è considerato trascurabile; invece la compatibilità per Vas è quella "tradizionale" alla luce del metodo precedentemente descritto , in quanto disponiamo di entrambi gli errori.
I risultati del caso tpulse = 2µs sono del tutto analoghi:
| Arduino | Simulazione | Compatibilità

V

(1)
peak | 438 ± 21 | 416.38 | 1.0 σ
(mV)
V

(2)
peak | 437 ± 21 | 416.68 | 1.0 σ
(mV)
t

(2)
peak | 1203.7 ± 0.2 | 1202.51 | 6.4 σ
(µs)
Vas | 56 ± 2 | 0.4 ± 0.02 | 25.5 (mV)

Tabella 12: confronto analitico tra le due forme d’onda per tpulse = 2µs

Il risultato è chiaro: nonostante la compatibilità tra i due picchi risulti buona, le due curve non hanno lo stesso comportamento asintotico, ossia è presente un certo offset che la calibrazione non riesce a prevedere. Si nota anche una certa incompatibilità tra gli istanti di tempo del secondo picco, che segnala un problema anche nella distribuzione temporale.
A scopo esemplificativo si riporta anche il caso tpulse = 5µs, ancora in linea con le considerazioni fatte. In realtà è stata effettuata tale analisi per tutti i valori interi intermedi tra quelli considerati, tuttavia non vengono riportati poiché i risultati risultano sempre gli stessi e riportarli risulterebbe ridondante.
In conclusione, è evidente che la calibrazione difettosa porta a problematiche nella posizione dello zero. In realtà anche il valore della slope nella calibrazione ha dei problemi che però sono nascosti dalla buona compatibilità dei picchi sperimentali con quelli simulati. Tuttavia la covarianza tra i due parametri di interpolazione è ovviamente non nulla, non è quindi sufficiente individuare l’offset dello zero e traslare il segnale di conseguenza: si andrebbe a perdere compatibilità in presenza del segnale.
| Arduino | Simulazione | Compatibilità

V

(1)
peak | 1049 ± 26 | 1036.72 | 0.5 σ
(mV)
V

(2)
peak | 1047 ± 26 | 1037.44 | 0.4 σ
(mV)
t

(2)
peak | 1205.8 ± 0.2 | 1203.59 | 12.2 σ
(µs)
Vas | 53 ± 2 | 1.07 ± 0.05 | 24.1 (mV)

Tabella 13: confronto analitico tra le due forme d’onda per tpulse = 5µs

Ci sono inoltre evidenti criticità anche sulla calibrazione temporale, sottolineate dall’incompatibilità del periodo del segnale misurato e quello simulato.

## 5 Conclusioni

Nel corso dell’analisi dati sono emersi alcuni punti critici, a partire dallo studio del preamplificatore, in cui si è osservato un comportamento anomalo del circuito rispetto al modello teorico ad alte frequenze, caratteristica confermata anche dalla cattiva compatibilità della pendenza della discesa lineare con il valore atteso. Tale effetto è imputabile a molteplici fattori, non per ultima l’oscillazione capacitiva dei componenti del circuito.
Questi stessi fattori potrebbero essere responsabili anche della cattiva riuscita del fit della forma d’onda in uscita dallo shaper non compensato, in risposta a un’onda quadra: i dati si staccano dal fit soprattutto in prossimità del picco, dove il χ
(2) riceve i contributi più rilevanti. La simulazione, che rappresenta il riferimento teorico assunto corretto, dà ragione al fit piuttosto che ai dati, motivo per cui si sospetta una cattiva configurazione del circuito costruito o un funzionamento non pulito dei suoi componenti.
Da queste problematiche è naturale aspettarsi che il grafico di Bode del circuito completo non sia ideale: in effetti la pendenza della discesa lineare è di nuovo incompatibile. Tuttavia, mentre queste complicazioni possono probabilmente spiegarsi alla luce del non perfetto apparato strumentale, è più difficile giustificare i cattivi risultati emersi dall’analisi dei dati acquisito con la scheda Arduino, che costituiscono il problema principale dell’esperienza. Le acquisizioni infatti sembrano descrivere solo sommariamente i dati e producono problemi di compatibilità, primo tra tutti il forte offset asintotico di tensione. Tali incongruenze sono probabilmente legate a una cattiva riuscita della calibrazione, che risulta difficile da spiegare: potrebbe essere dovuta a problemi della scheda di acquisizione o, forse, nell’algoritmo di ricerca dei massimi e dei periodi. Non si esclude nemmeno che le problematiche sorgano dal fatto che l’acquisizione si è svolta una settimana dopo il resto della presa dati, e il circuito, seppur riposto e recuperato identico, potrebbe aver subito qualche modifica accidentale e imprevedibile.

## A Appendici

A.1 Costruzione dell’errore sulle misure

Nel trattare i dati rilevati dall’oscilloscopio nel corso dell’esperienza si sono assegnati gli errori alle misure tenendo conto che ogni misura è affetta da un’incertezza di origine sistematica e da una di lettura, dovuta al posizionamento dei cursori sulla schermata. Per semplificare il calcolo degli errori, si sceglie di considerare un errore massimo ∆% di tipo percentuale per identificare il contributo sistematico presente nella presa dati, e un errore massimo ∆lett per coprire le fluttuazioni casuali. La percentuale del valore letto da utilizzare come ∆% è del 3% per le tensioni e dello 0.01% sui tempi: per quanto riguarda invece l’errore di lettura, si è considerato 1/10 della divisione utilizzata. Tuttavia, poiché l’errore percentuale sui tempi è sempre decisamente trascurabile rispetto a quello di lettura, lo si è omesso nel calcolo dell’incertezza totale.
Infine, si precisa che tutti i risultati sono presentati con un errore non massimo, ma di tipo statistico: si riporta la regola di conversione, in ipotesi di distribuzione uniforme per l’errore sistematico e in ipotesi di distribuzione triangolare per l’errore di lettura.

σ% =

2∆%
√
12

σlett =

2∆lett
√
24

(15)

Un meccanismo analogo vale per le misure dirette di grandezze quali resistenze e capacità effettuate con il multimetro: anche in questo caso abbiamo un contributo sistematico e uno casuale, il primo dato ancora da un errore percentuale e il secondo da un errore in digit. Tale contributo in digit è dato da ∆dgt = ns dove n = #digit è un numero intero riportato sul manuale dello strumento e s è la sensibilità usata nella lettura del valore. Anche qui si utilizza la conversione in errori statistici in ipotesi di distribuzione uniforme.

A.2 Commento sull’accettazione/rifiuto dei fit

Nel corso della relazione sono stati riportati diverse volte i parametri per la verifica della bontà del fit, sostenendo che essi permettessero di accettare o rifiutare l’interpolazione. Per quanto riguarda i valori di χ

(2), l’ipotesi che il fit
descriva i dati viene accettata o rifiutata con 0.90 CL, mentre per il valore di t di Student l’ipotesi di non correlazione è stata rifiutata o accettata con lo stesso CL.
Il valore di χ
(2) riportato nel caso di fit con errori sia in ascissa che in ordinata sono calcolati, in accordo con la documentazione di ROOT, secondo:

(y − f1(x))²
ey² + ( ¹
2

(exl + exh)f1

0(x))²

Si specifica inoltre che per i fit effettuati con errore costante il valore di χ

(2), se riportato si riferisce alla somma dei residui al quadrato, non normalizzati.

A.3 Tabella delle compatibilità

λ = √

|a−b|
σ

2
a+σ

2
b

Compatibilità

0≤ λ<1 | Ottima
1≤ λ<2 | Buona
2≤ λ<3 | Accettabile
3≤ λ<5 | Pessima
λ ≥ 5 | Non compatibile

Tabella 14: indicazioni lettura compatibilità

A.4 Dati sperimentali

t (µs) | div (µs) | V

max
pre | (mV) | div (mV)
2 | 25 | -176 | 50
4 | 25 | -352 | 100
6 | 25 | -520 | 100
8 | 25 | -680 | 100
10 | 25 | -848 | 200

Tabella 15: verifica linearità tra durata impulso e V

max
pre nel
preamplificatore

t (µs) V

max
pre | (mV)
div = 50 µs | div = 50 mV
38 | -144
78 | -120
116 | -100
156 | -82
196 | -68
242 | -56
292 | -44
404 | -26

Tabella 16: misura scarica RC

f (Hz) | Vin (V) | div (mV) | Vout | div
10 | 1.06 | 200 | 19.2 V | 5 V
31 | 1.06 | 200 | 19.2 V | 5 V
96 | 1.06 | 200 | 19 V | 5 V
298 | 1.06 | 200 | 17.6 V | 5 V
924 | 1.06 | 200 | 11.3 V | 2 V
2863 | 1.06 | 200 | 4.64 V | 1 V
8875 | 1.06 | 200 | 1.56 V | 500 mV
27513 | 1.05 | 200 | 516 mV | 100 mV
85289 | 1.05 | 200 | 170 mV | 50 mV
264396 | 1.05 | 200 | 57.6 mV | 20 mV
819628 | 1.05 | 200 | 21.6 mV | 20 mV

Tabella 17: risposta in frequenza del preamplificatore

f (Hz) | Vin | div (mV) | Vout (mV) | div (mV)
100 | 1.01 V | 200 | 10.4 | 20
250 | 1.01 V | 200 | 24 | 20
625 | 1.01 V | 200 | 60 | 20
1563 | 992 mV | 200 | 144 | 20
3906 | 992 mV | 200 | 322 | 50
9766 | 992 mV | 200 | 476 | 100
24414 | 992 mV | 200 | 332 | 100
61035 | 984 mV | 200 | 151 | 20
152588 | 984 mV | 200 | 61.6 | 20
381470 | 984 mV | 200 | 24.8 | 20
953674 | 992 mV | 200 | 11.2 | 20

Tabella 18: risposta in frequenza dello shaper

t (µs) V

max
pre | (mV)
div = 10 µs | div = 50 mV
3.2 | 142
6.8 | 256
11.6 | 328
15.6 | 346
19.2 | 340
27.2 | 298
32.8 | 248
41.2 | 184
46 | 152
54.4 | 106
64.4 | 66
77.2 | 36
85.2 | 24

Tabella 19: forma d’onda dello shaper

t (µs) V

max
sh | (mV) | div (mV)
2 | -60 | 20
4 | -119 | 20
6 | -174 | 50
8 | -234 | 50
10 | -292 | 50

Tabella 20: verifica linearità tra durata impulso e V

max
sh
nello shaper
t (µs) | Vout | div (mV)
2 | 476 mV | 100
4 | 944 mV | 200
6 | 1.39 V | 200
8 | 1.86 V | 500
10 | 2.3 V | 500

Tabella 21: verifica linearità tra durata impulso e Vout nella catena elettronica

f (Hz) | Vin (V) | div (mV) | Vout | div
10 | 1.06 | 200 | 12 V | 2 V
31 | 1.06 | 200 | 12 V | 2 V
96 | 1.07 | 200 | 12 V | 2 V
298 | 1.07 | 200 | 11.5 V | 2 V
924 | 1.07 | 200 | 9.52 V | 2 V
2863 | 1.06 | 200 | 7.84 V | 2 V
8875 | 1.06 | 200 | 5.52 V | 2 V
27513 | 1.06 | 200 | 1.34 V | 200 mV
85289 | 1.06 | 200 | 164 mV | 50 mV
264396 | 1.04 | 200 | 19.2 mV | 20 mV
819628 | 1.05 | 200 | 3.2 mV | 20 mV

Tabella 22: risposta in frequenza della catena elettronica
