aidinattar/RelazioneCatenaElettronica/catena.pdf

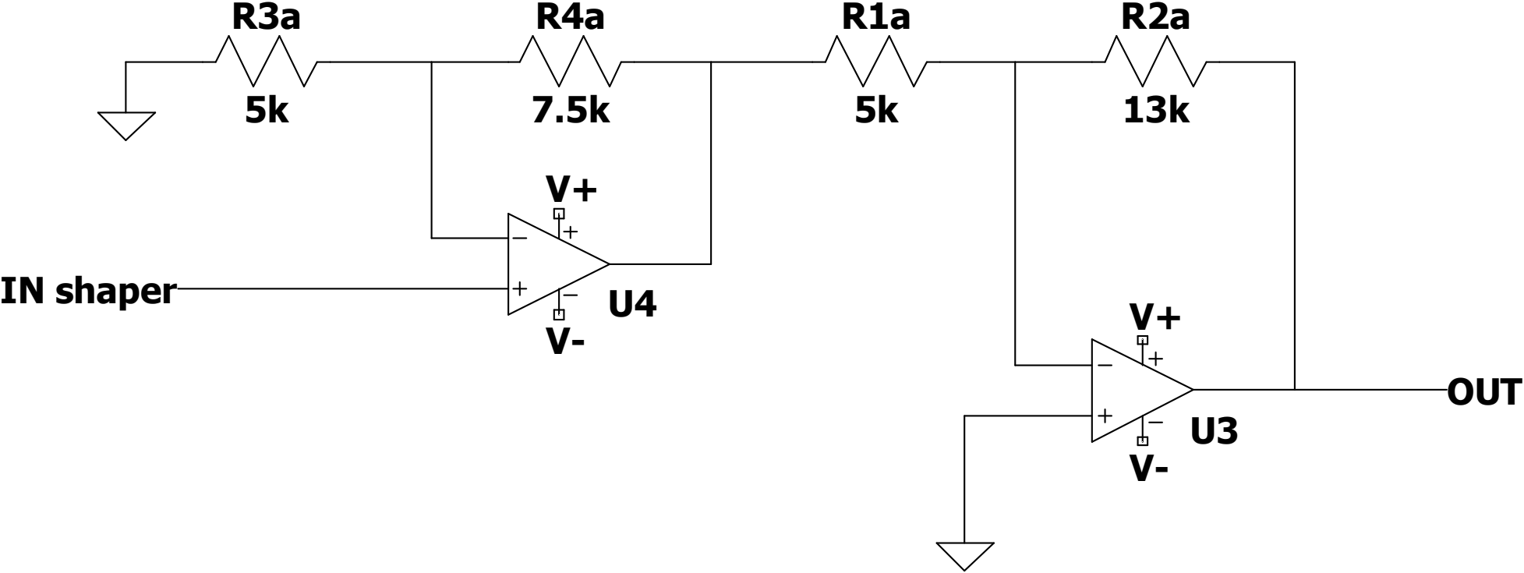
[picture p29: figure]
OUT; IN shaper
