aidinattar/RelazioneCatenaElettronica/shaper.pdf

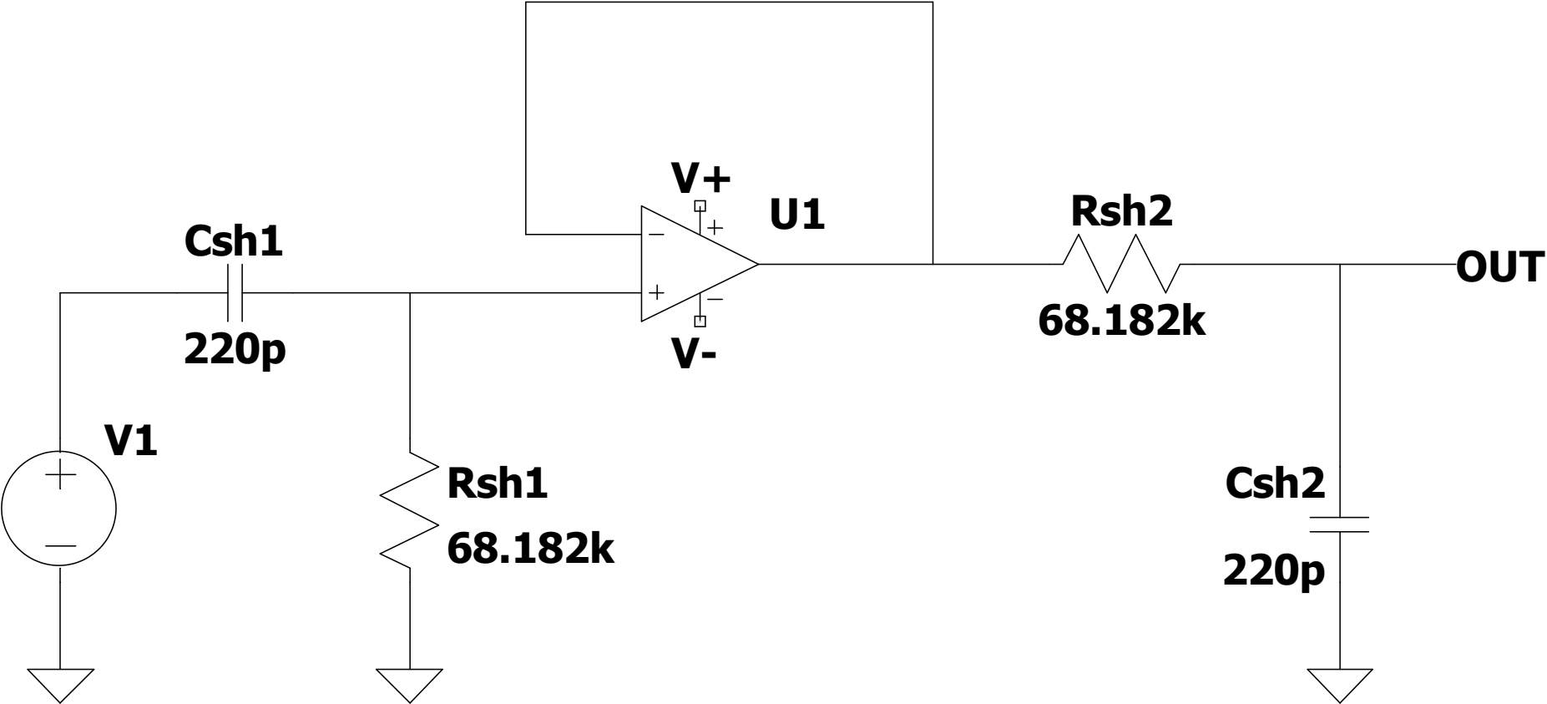
[picture p30: figure]
Csh1; Csh2; Rsh1 68.182k; Rsh2; OUT
