aidinattar/RelazioneCatenaElettronica/calibtempi.pdf

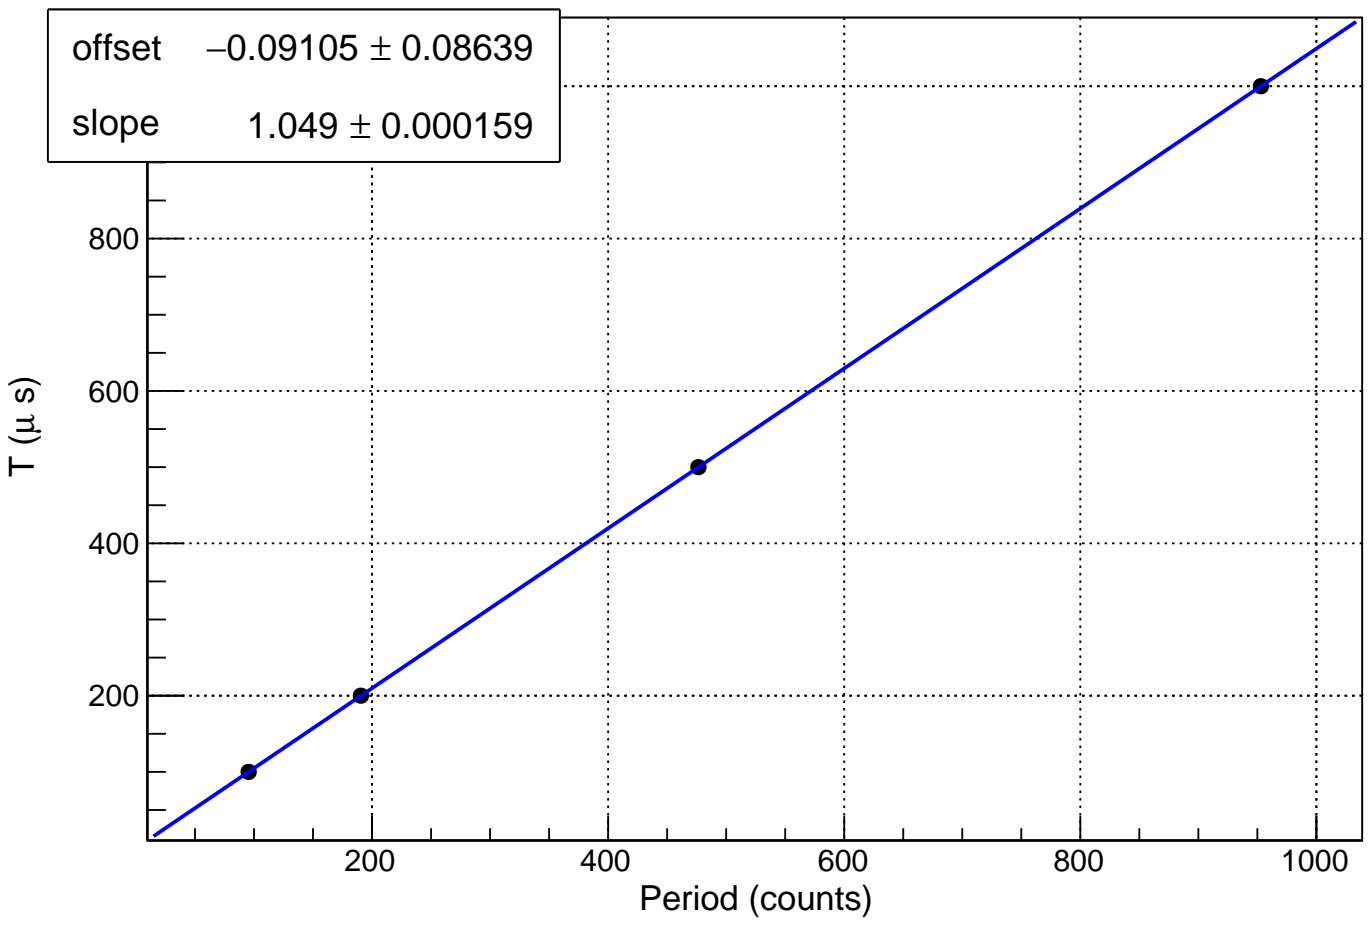
[picture p31: figure]
Period (counts); offset −0.09105 ± 0.08639; slope
