aidinattar/RelazioneCatenaElettronica/bodepreampresidui.pdf

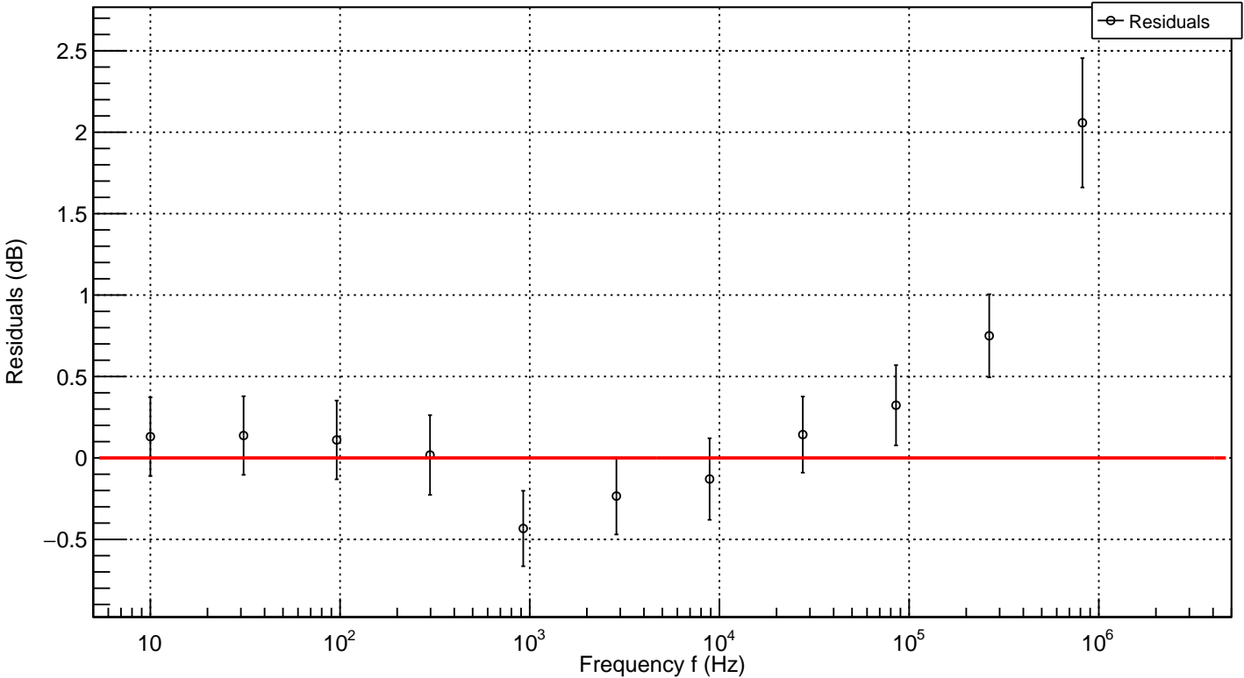
[picture p32: figure]
Frequency f (Hz) −0.5; Residuals (dB); Residuals
