aidinattar/RelazioneCatenaElettronica/residuicatenadiscesa.pdf

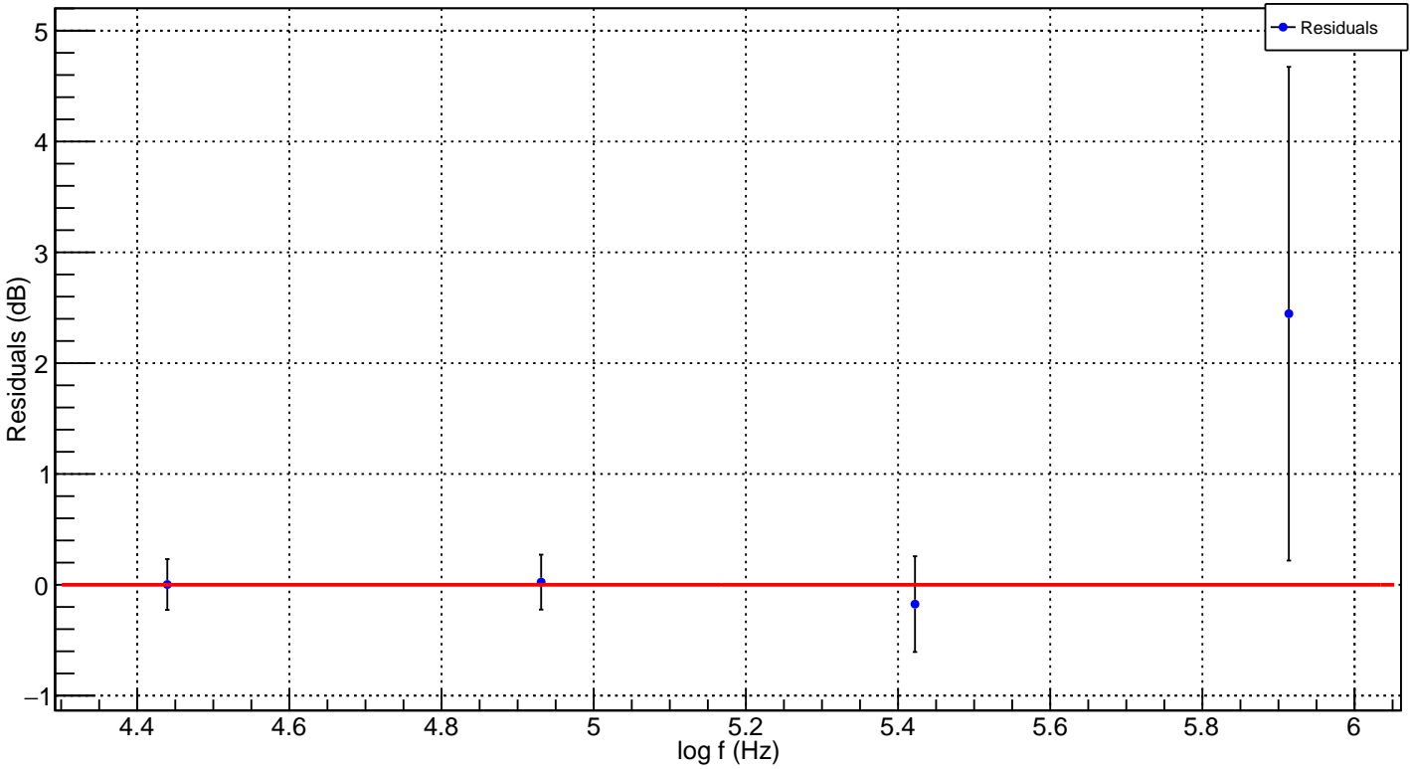
[picture p33: figure]
log f (Hz); Residuals (dB); Residuals
