aidinattar/RelazioneCatenaElettronica/residuipreamplineare.pdf

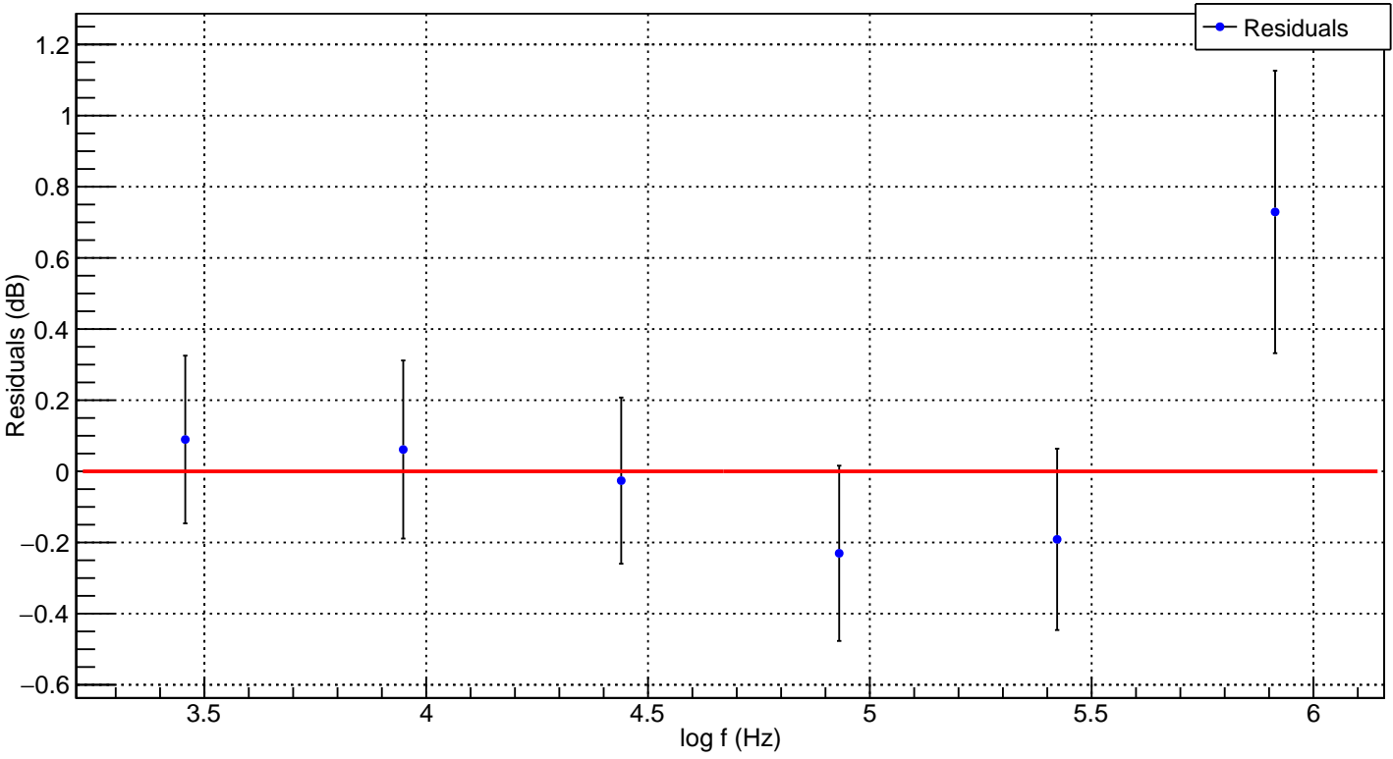
[picture p34: figure]
log f (Hz) −0.6 −0.4 −0.2; Residuals (dB); Residuals
