aidinattar/RelazioneCatenaElettronica/residuishaperdiscesa.pdf

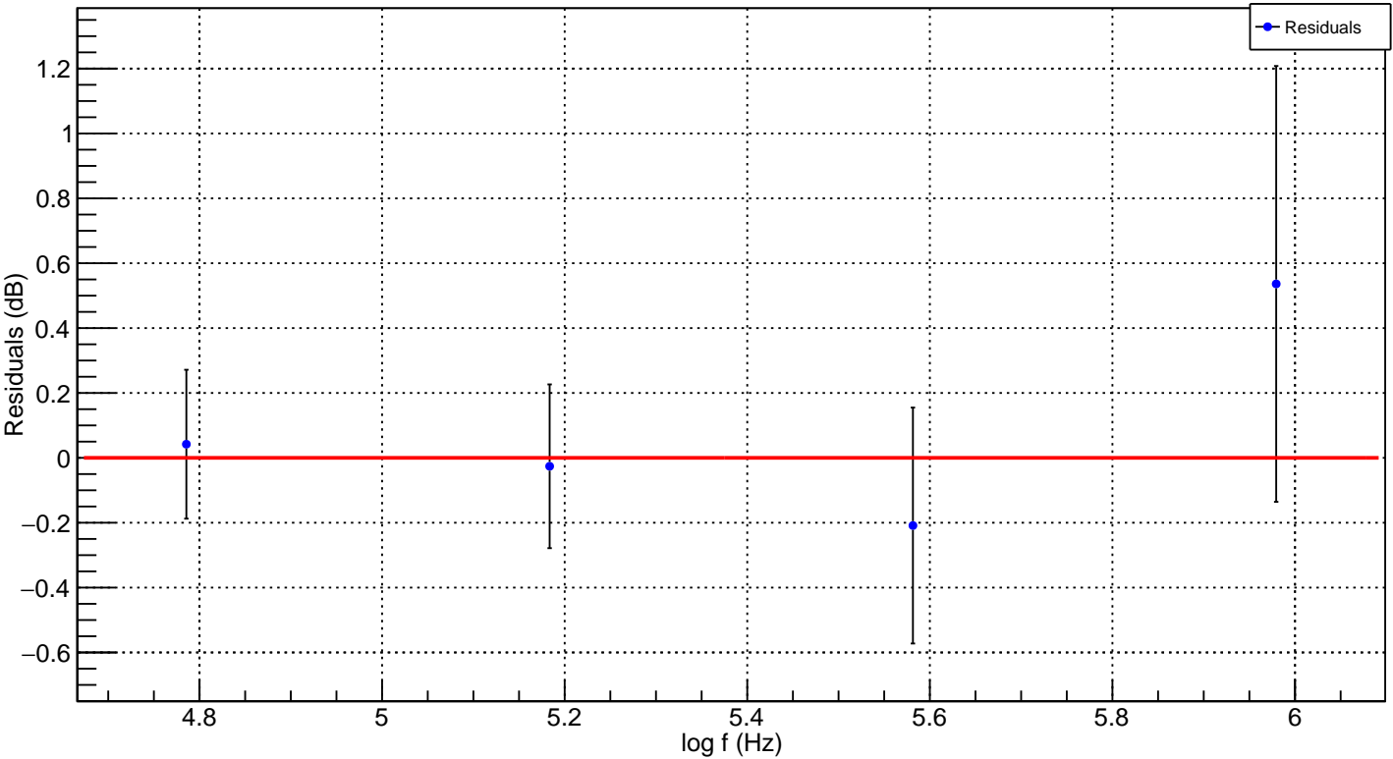
[picture p35: figure]
log f (Hz) −0.6 −0.4 −0.2; Residuals (dB); Residuals
