aidinattar/RelazioneCatenaElettronica/residuishapersalita.pdf

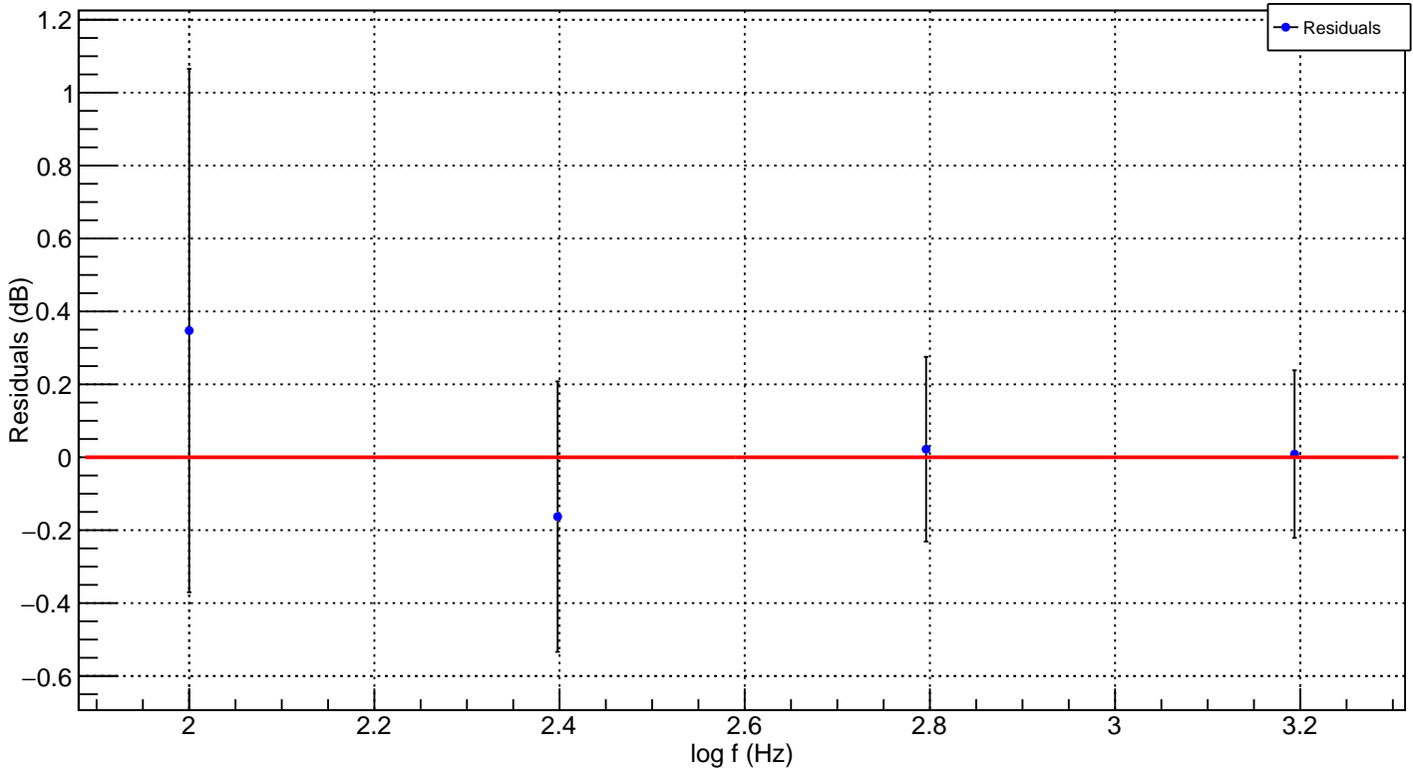
[picture p36: figure]
log f (Hz); Residuals (dB); Residuals
