aidinattar/RelazioneCatenaElettronica/calibtempiresidui.pdf

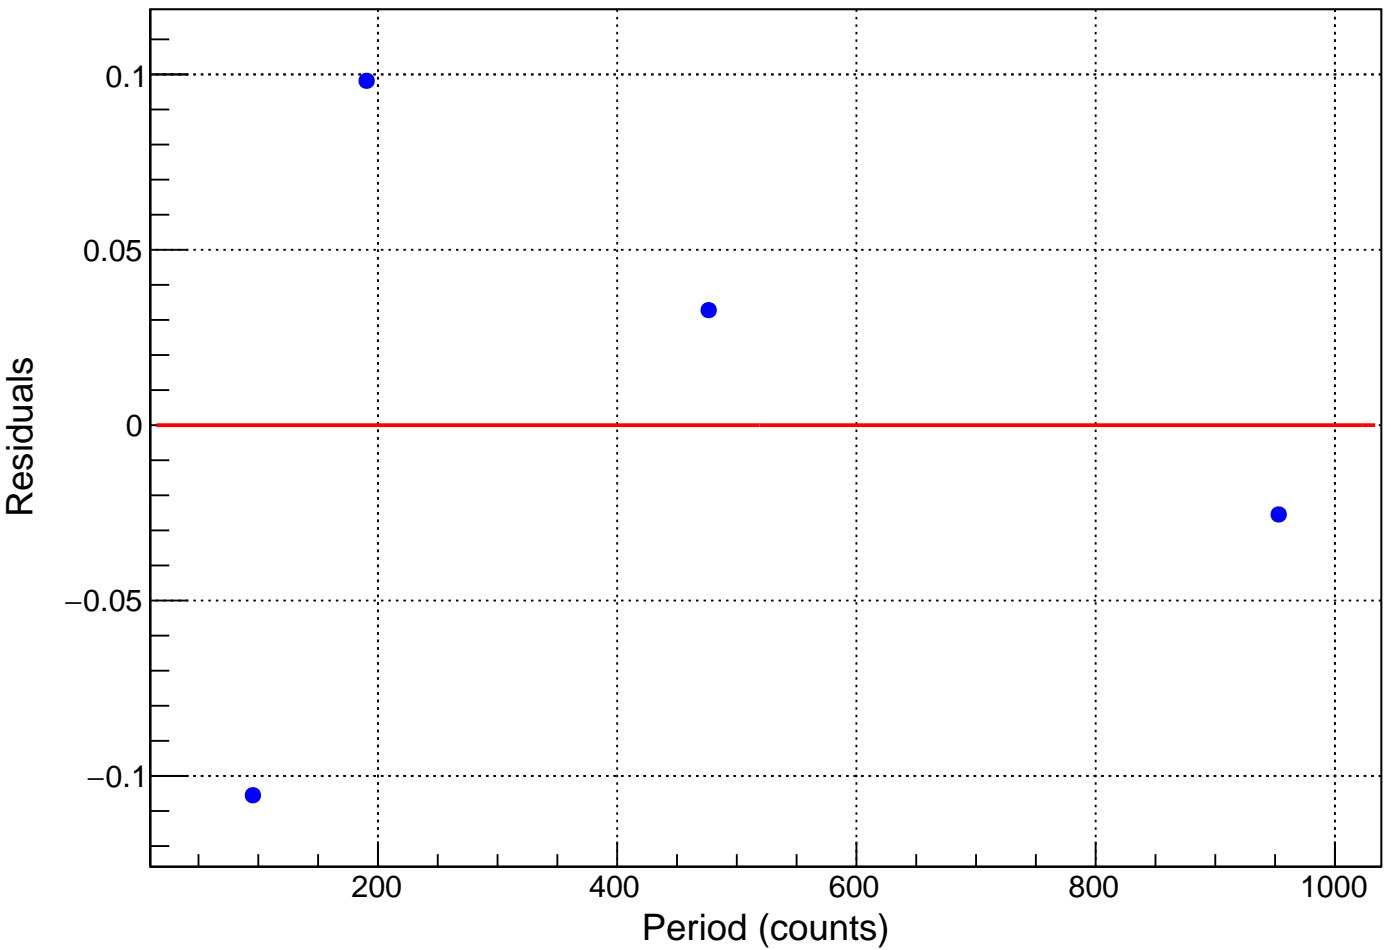
[picture p37: figure]
Period (counts) −0.1 −0.05; Residuals
