aidinattar/RelazioneCatenaElettronica/residui_forma_onda_no_pz.pdf

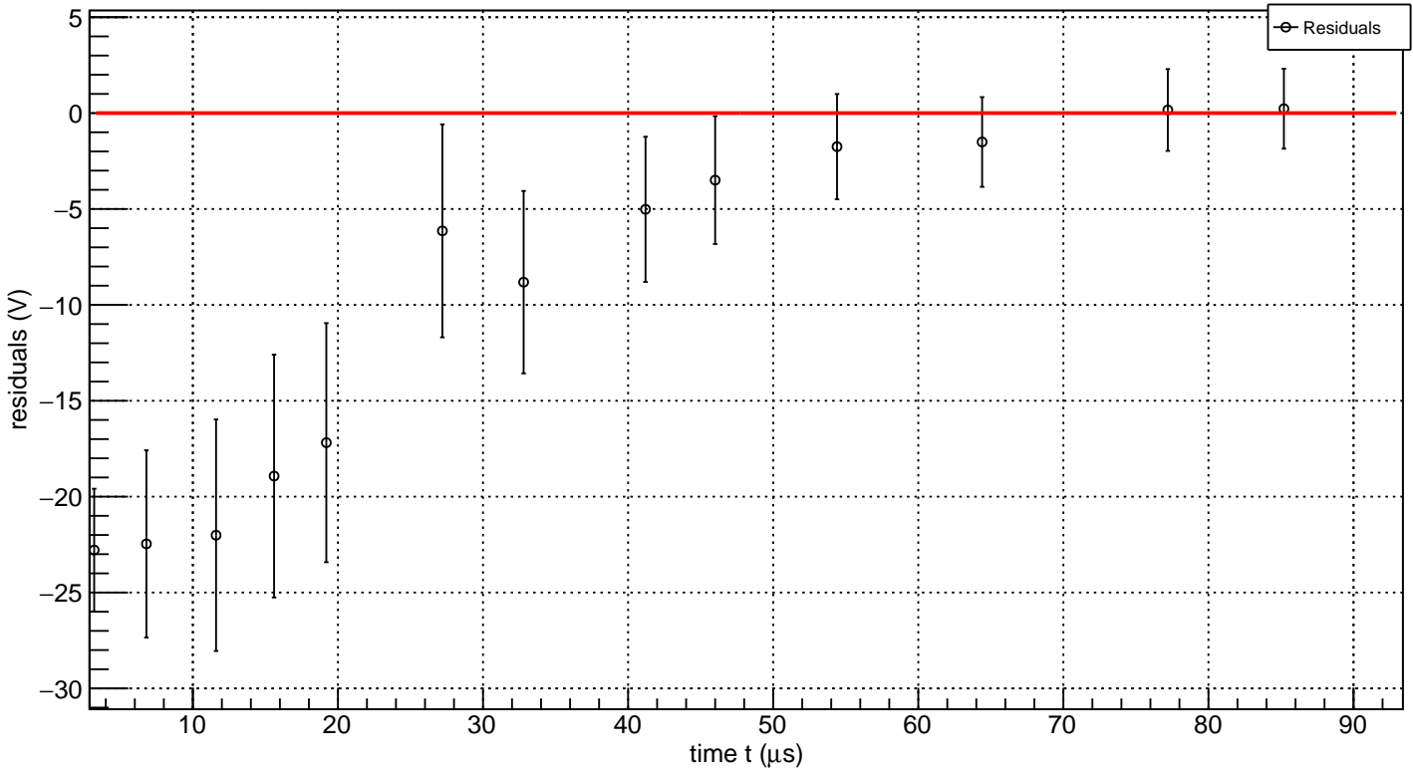
[picture p38: figure]
time t (µs) −30 −25 −20 −15 −10−5; residuals (V); Residuals
