aidinattar/RelazioneCatenaElettronica/bodecatenaresidui.pdf

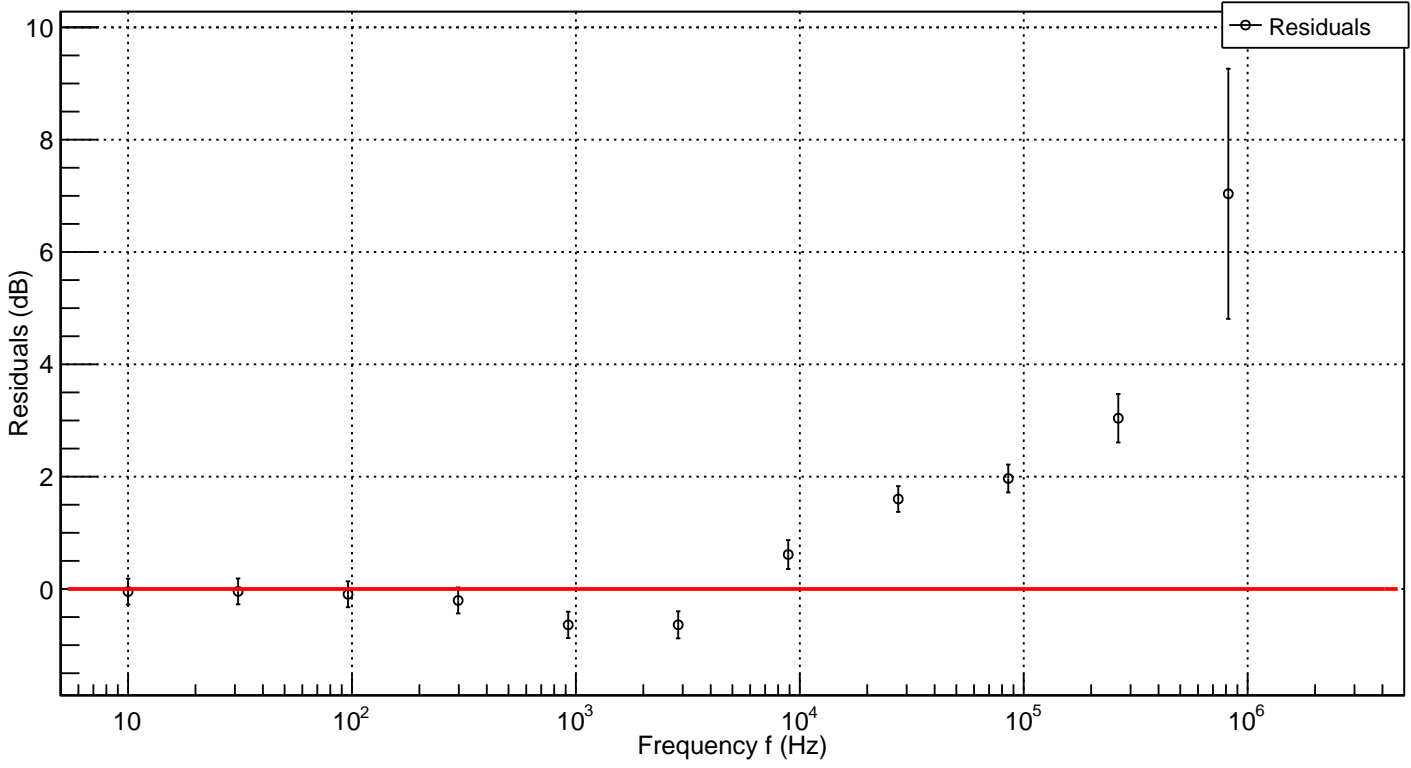
[picture p39: figure]
Frequency f (Hz); Residuals (dB); Residuals
