aidinattar/RelazioneCatenaElettronica/bodeshaperresidui_no_pz.pdf

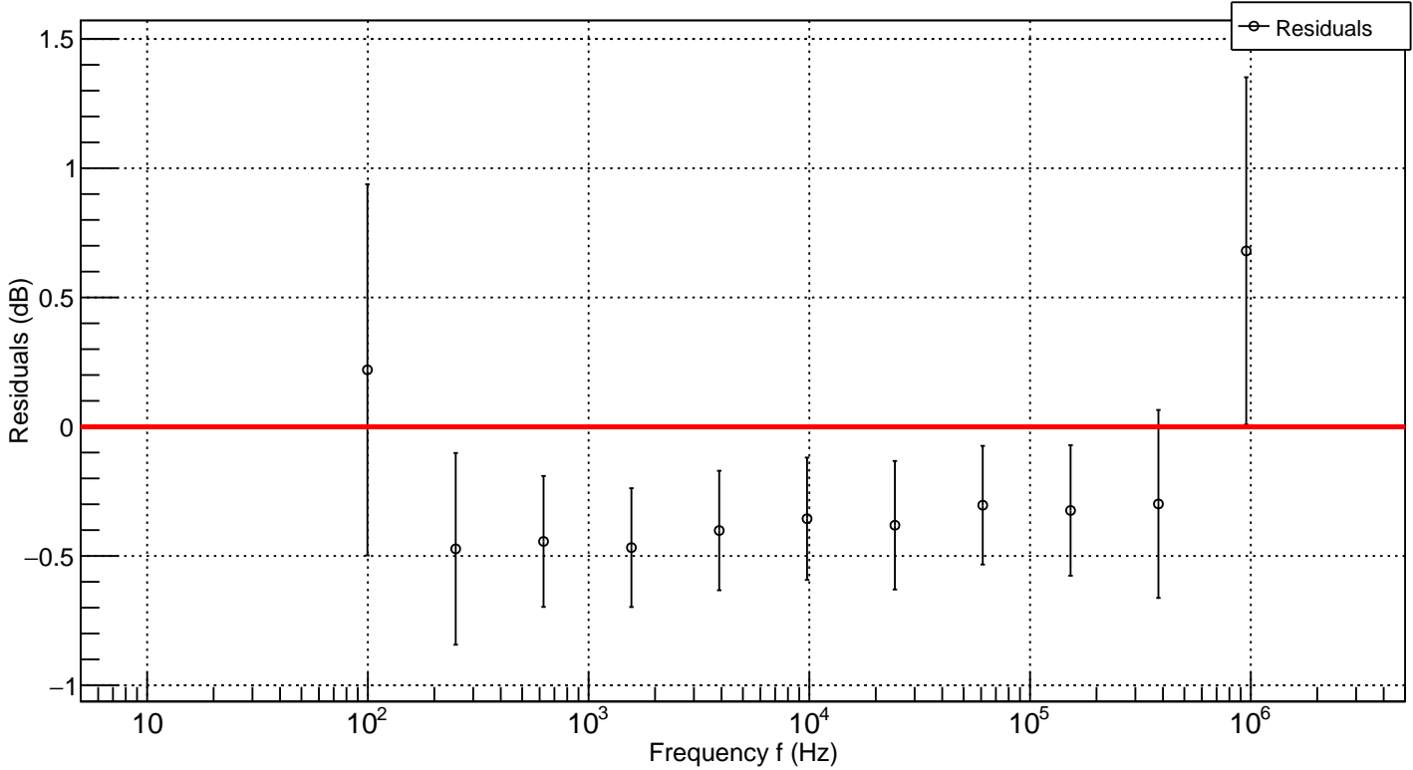
[picture p40: figure]
Frequency f (Hz) −1 −0.5; Residuals (dB); Residuals
