aidinattar/RelazioneCatenaElettronica/fitcatena.pdf

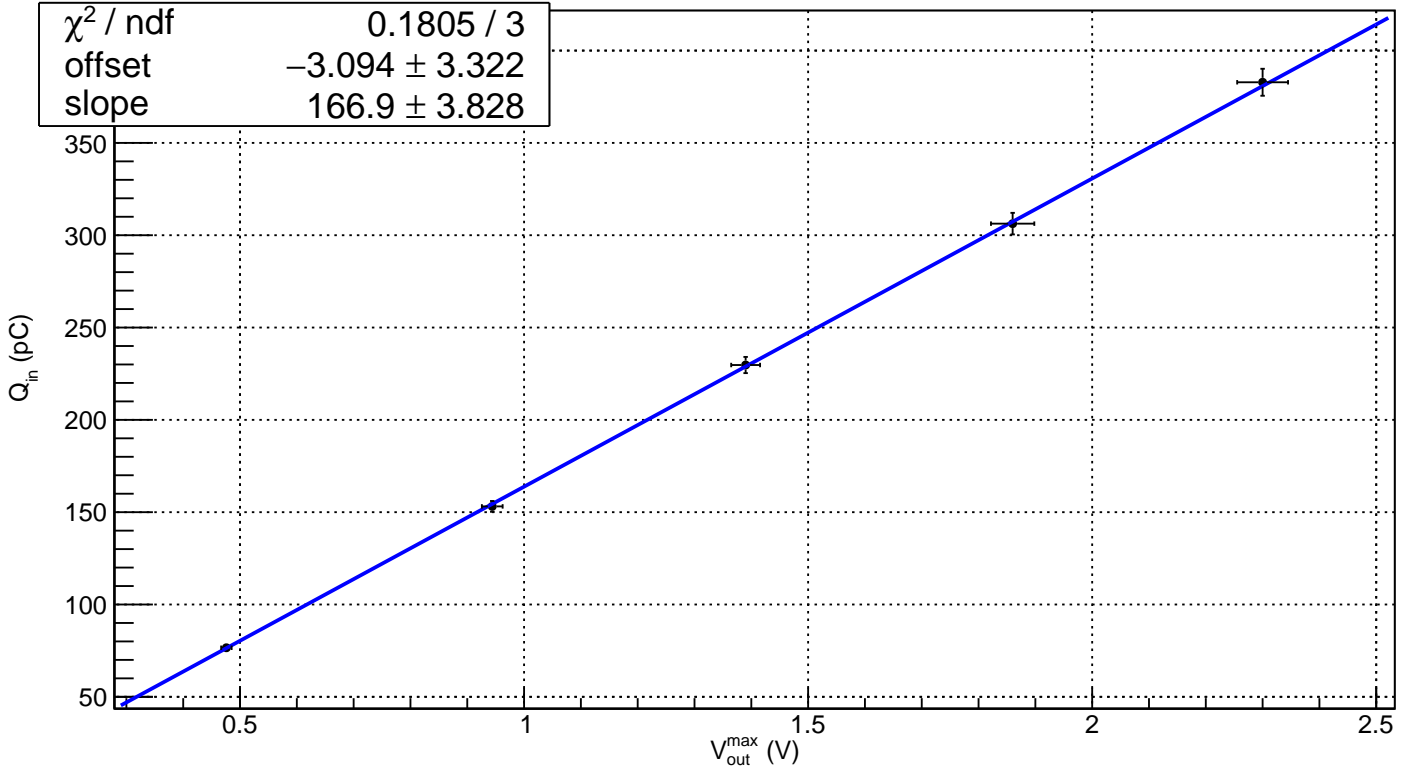
[picture p41: figure]
(V) max Vout; / ndf ² χ; offset; slope
