aidinattar/RelazioneCatenaElettronica/fitpreamp.pdf

| / ndf ² χ / ndf ² χ | 0.6464 / 3 0.6464 / 3

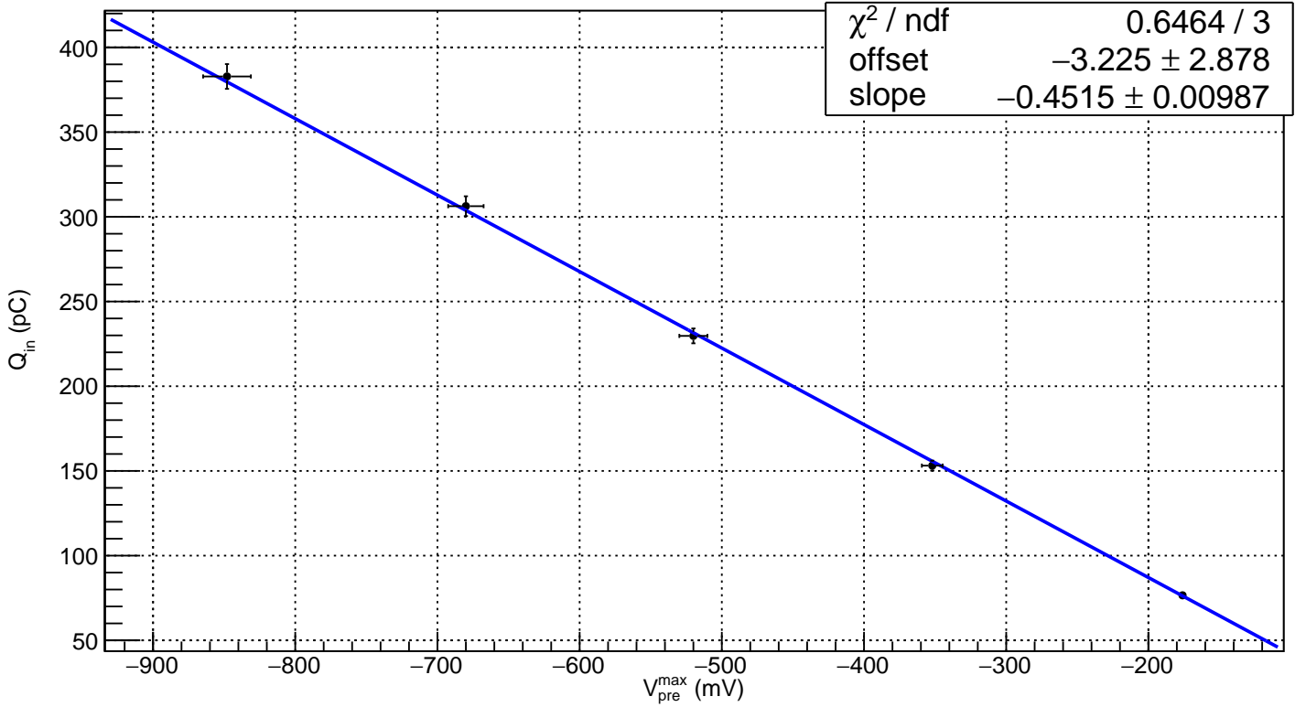
[picture p42: figure]
(mV) max Vpre

offset offset slope slope | −0.4515 ± 0.00987 −0.4515 ± 0.00987 | −3.225 ± 2.878 −3.225 ± 2.878
