aidinattar/RelazioneCatenaElettronica/fitshaper.pdf

/ ndf ² χ / ndf ² χ | 0.2563 / 3 0.2563 / 3

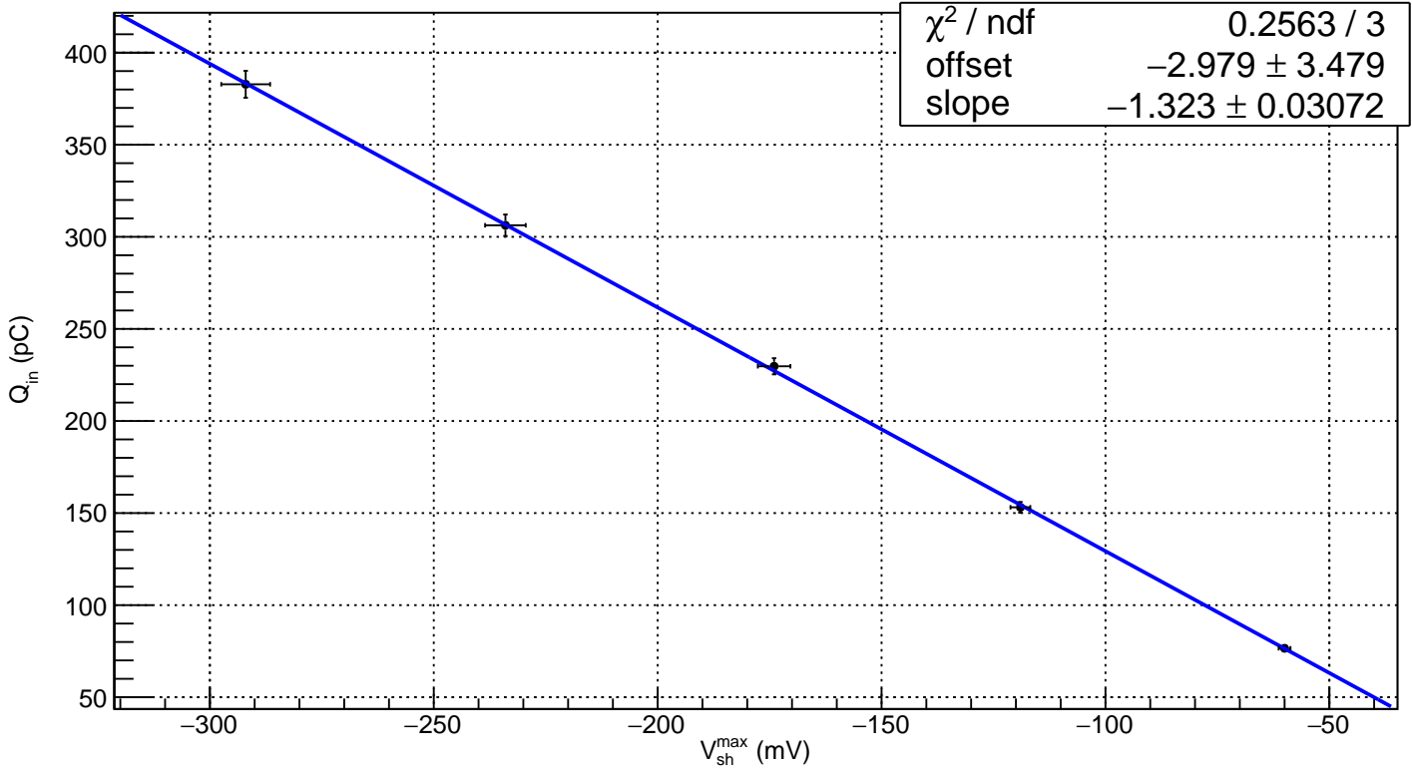
[picture p43: figure]
(mV) max Vsh

offset offset slope slope | −2.979 ± 3.479 −2.979 ± 3.479 −1.323 ± 0.03072 −1.323 ± 0.03072
