aidinattar/RelazioneCatenaElettronica/preampRCresidui.pdf

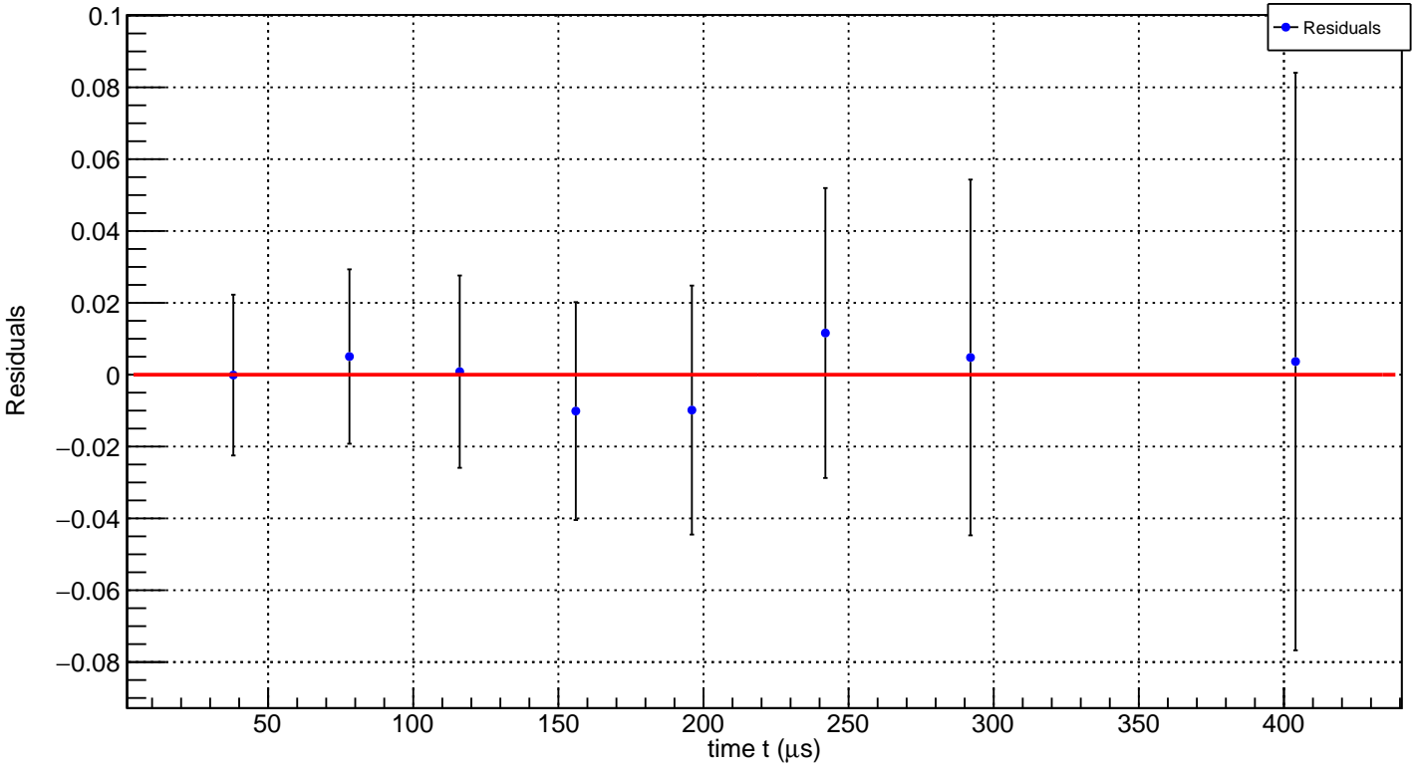
[picture p44: figure]
time t (µs) −0.08 −0.06 −0.04 −0.02; Residuals
