aidinattar/RelazioneCatenaElettronica/residuicatena.pdf

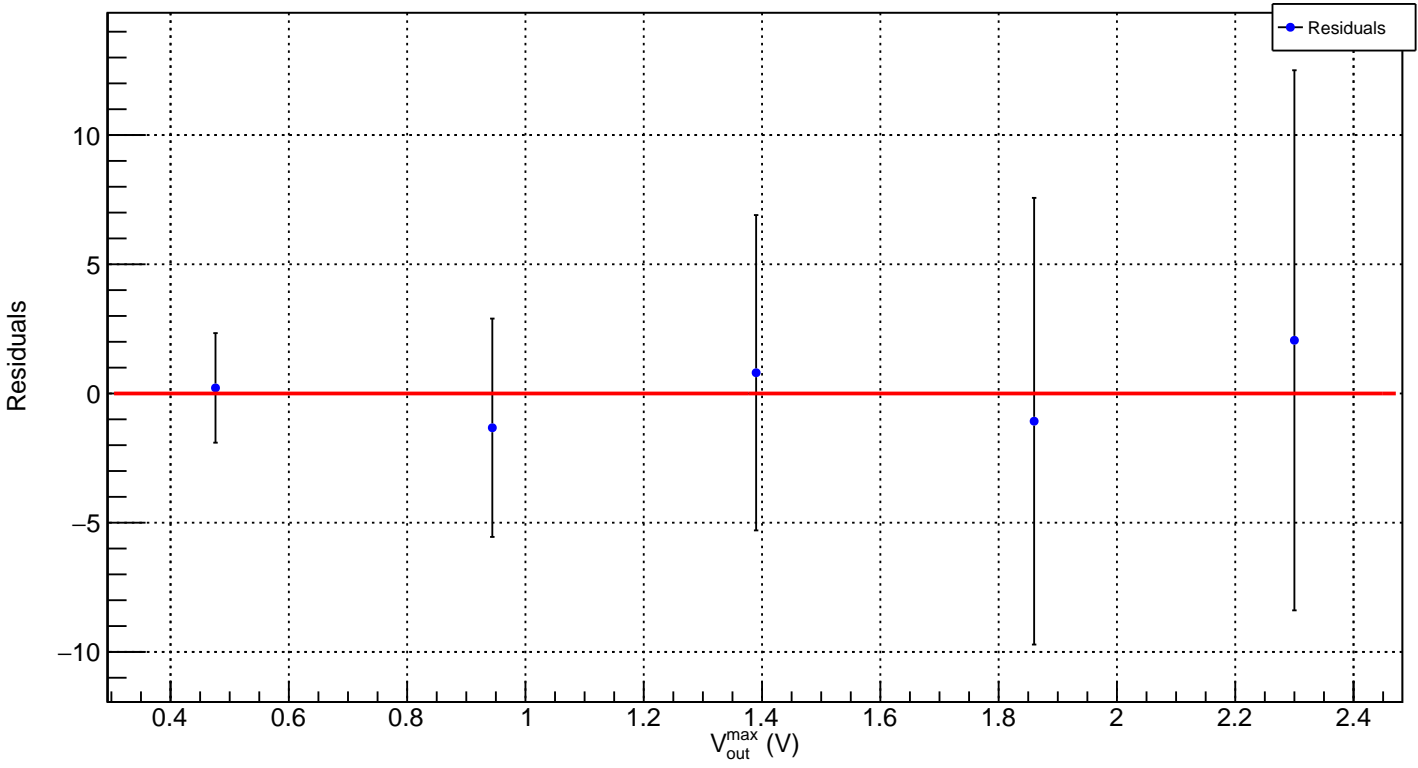
[picture p45: figure]
(V) max Vout −10−5; Residuals
