aidinattar/RelazioneCatenaElettronica/residuipreamp.pdf

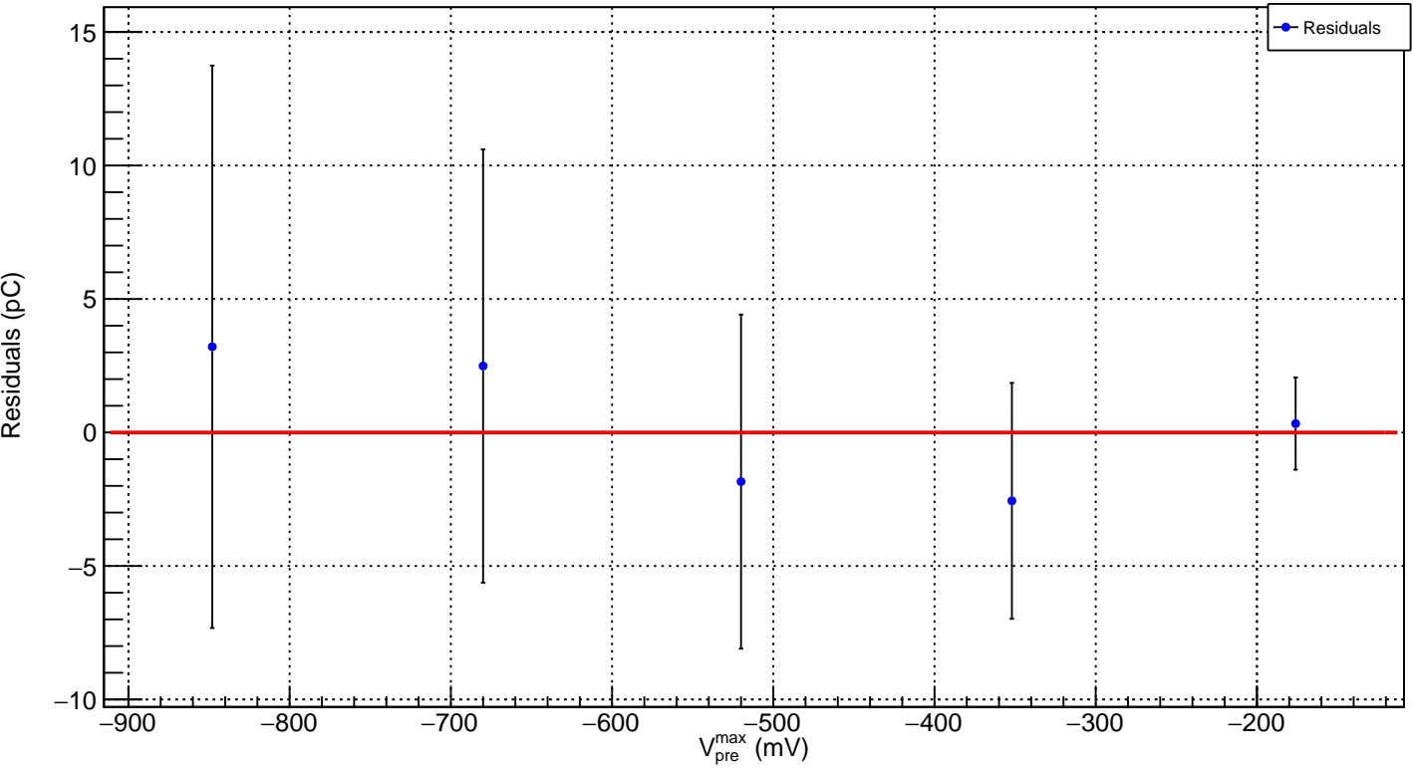
[picture p46: figure]
(mV) max Vpre −10−5; Residuals (pC); Residuals
