aidinattar/RelazioneCatenaElettronica/residuishaper.pdf

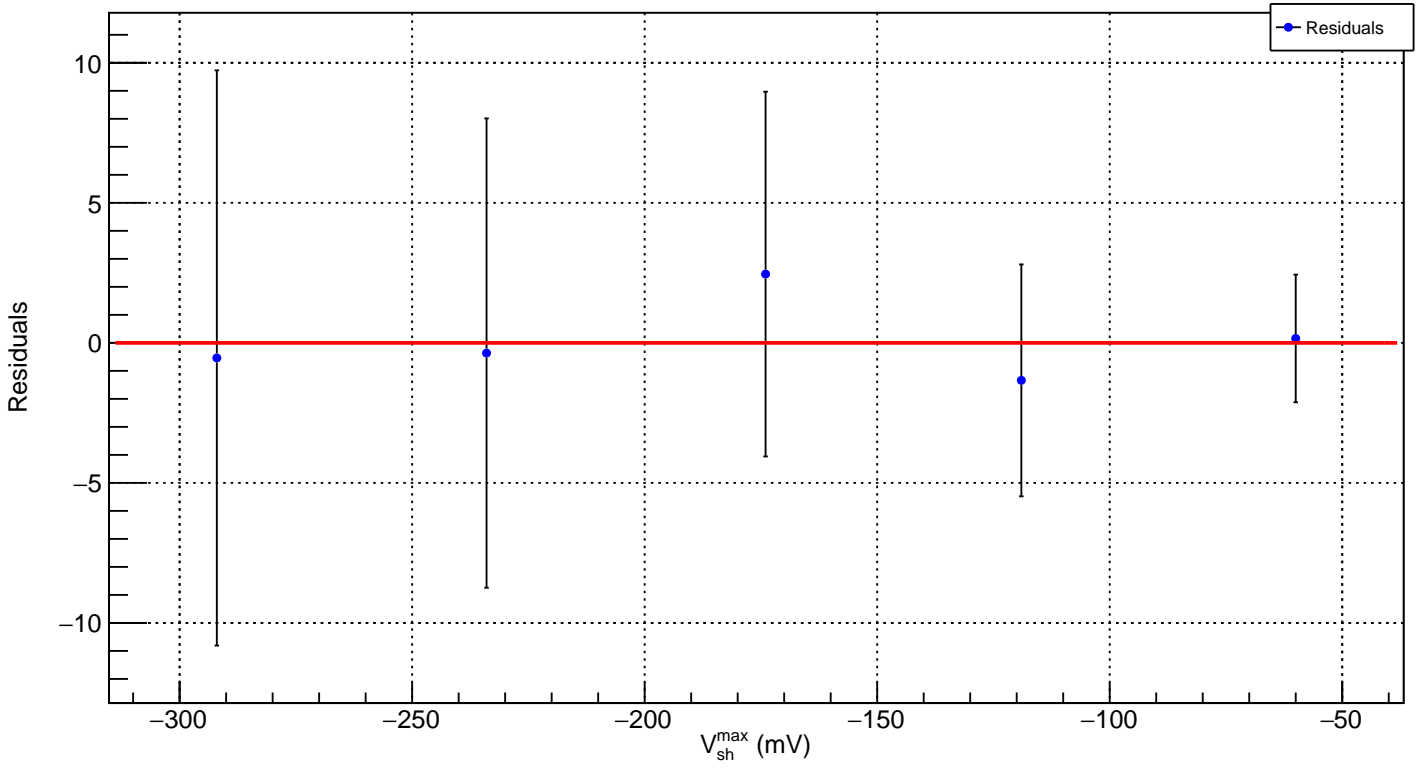
[picture p47: figure]
(mV) max Vsh −10−5; Residuals
