aidinattar/RelazioneCatenaElettronica/alimentazione.png

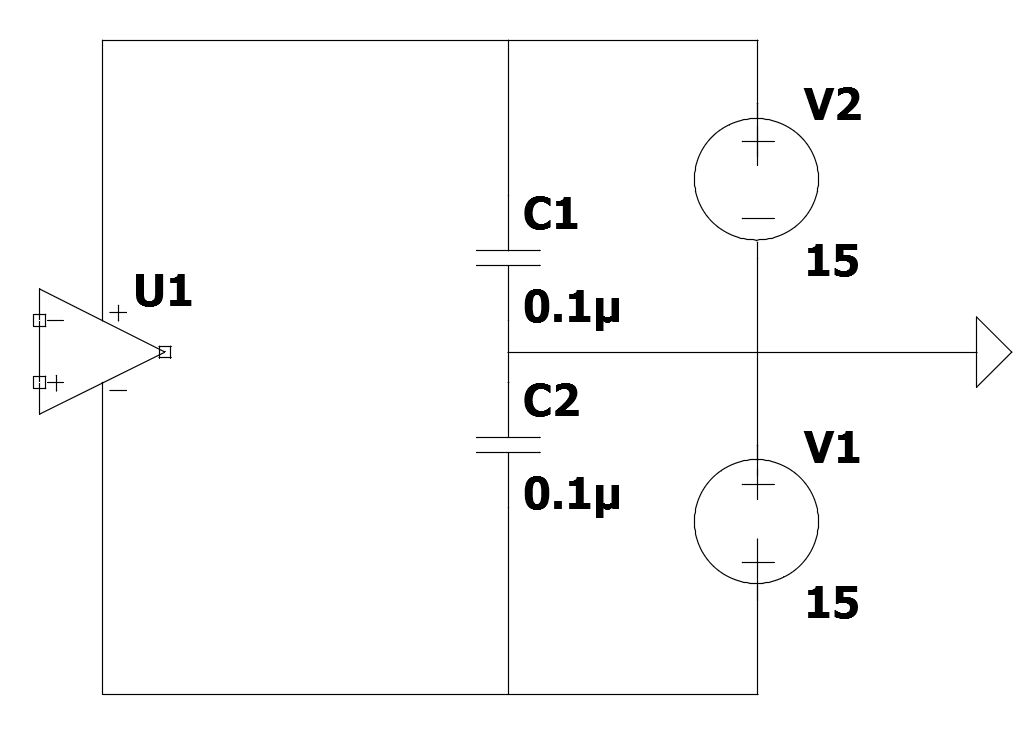
alimentazione.png
