aidinattar/RelazioneCatenaElettronica/logbook/1_3.pdf

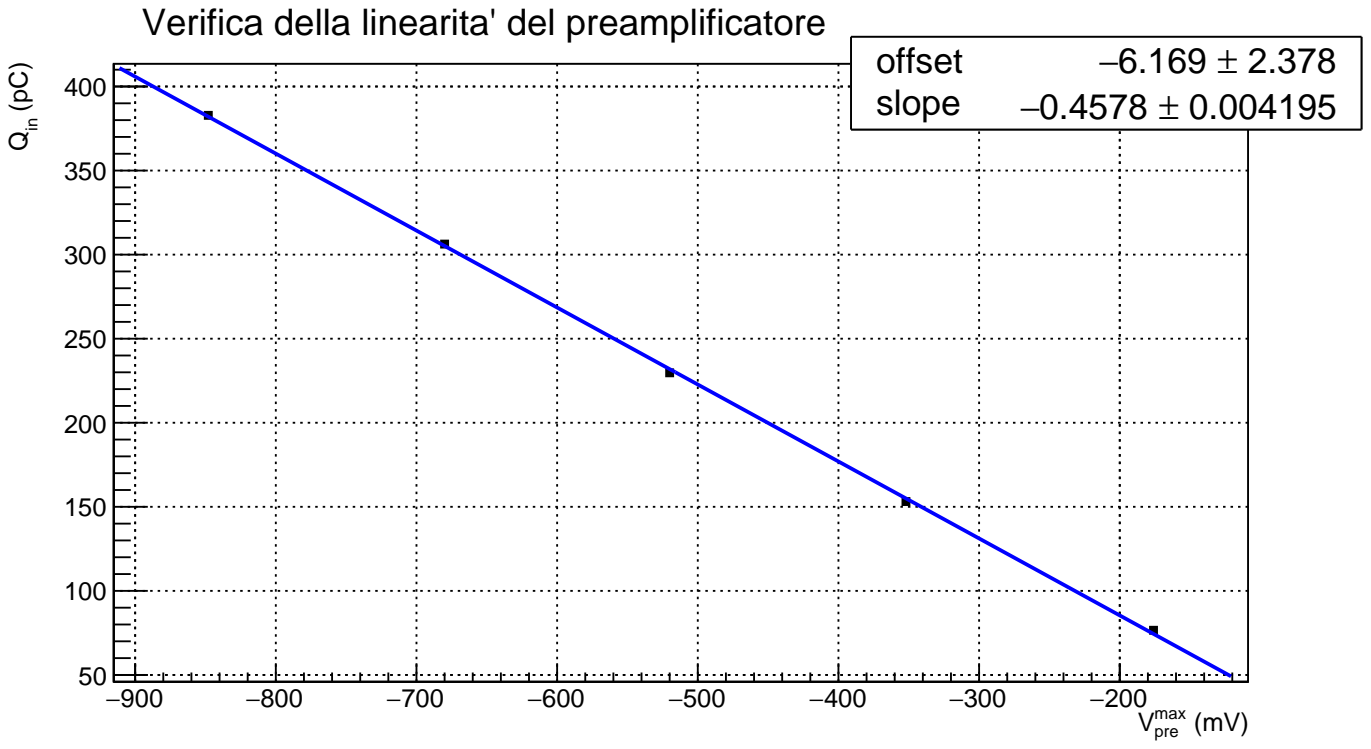
[picture p49: figure]
(mV) max Vpre; offset; slope; Verifica della linearita' del preamplificatore
