aidinattar/RelazioneCatenaElettronica/logbook/1_5.pdf

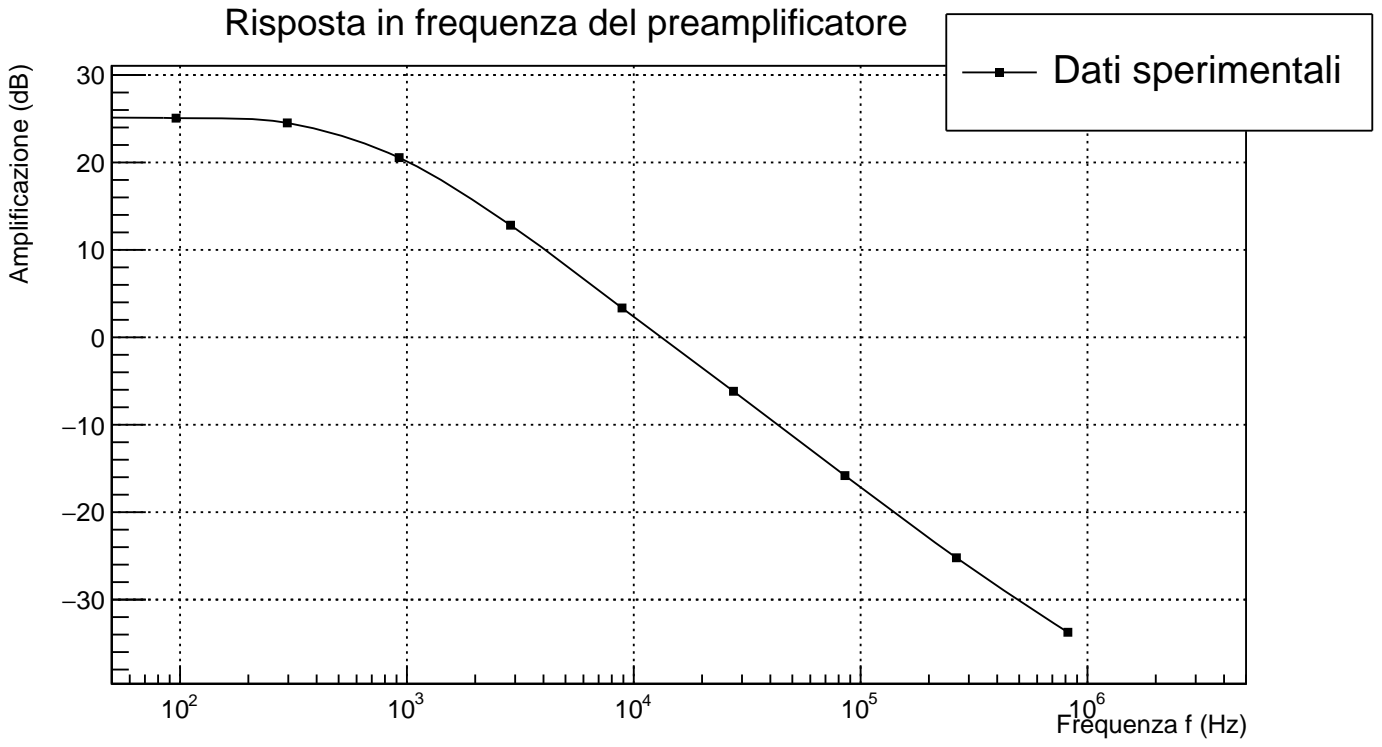
[picture p50: figure]
Amplificazione (dB)Dati sperimentali

2 10 | 3 10 | 4 10 | 5 10 | 6 10 Frequenza f (Hz) −30 −20 −10

## Risposta in frequenza del preamplificatore
