aidinattar/RelazioneCatenaElettronica/logbook/2_2.pdf

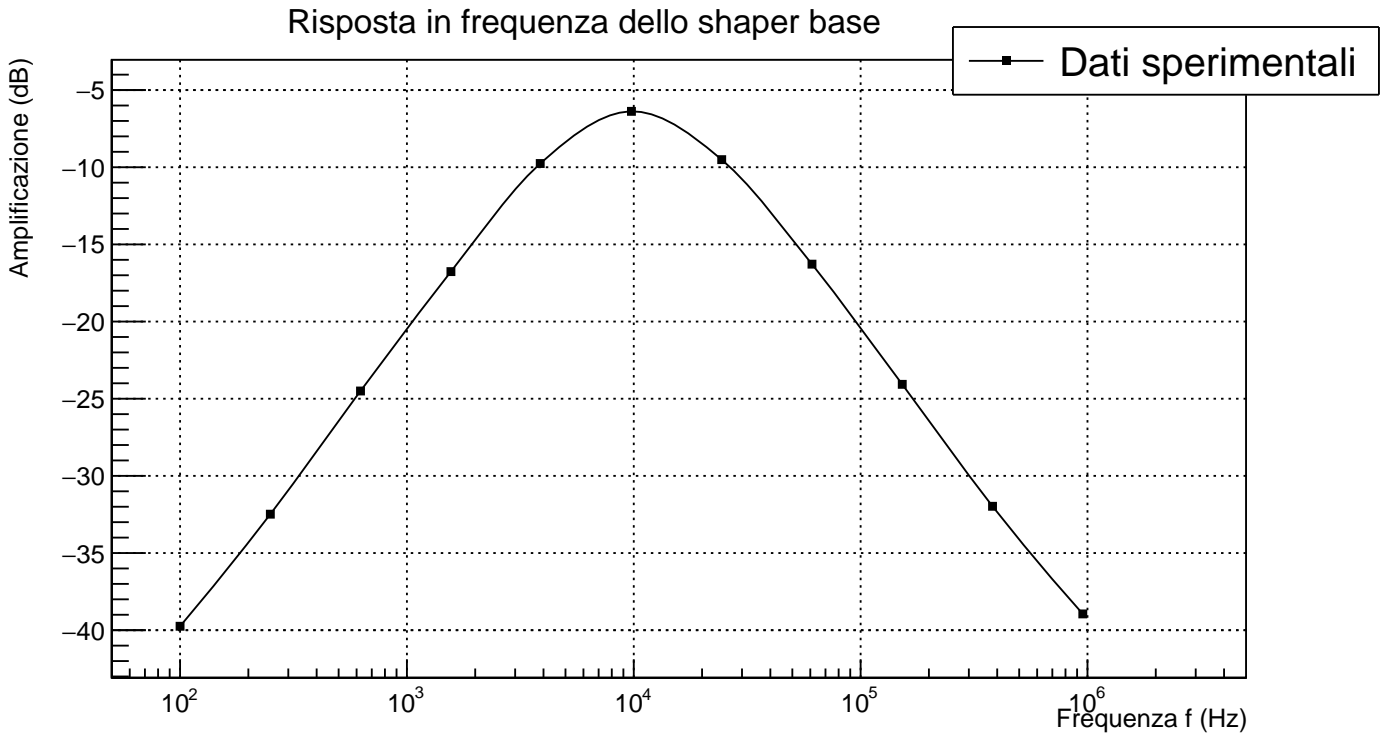
[picture p51: figure]
Amplificazione (dB)Dati sperimentali; Risposta in frequenza dello shaper base

2 10 | 3 10 | 4 10 | 5 10 | 6 10 Frequenza f (Hz) −40 −35 −30 −25 −20 −15 −10−5
