aidinattar/RelazioneCatenaElettronica/logbook/2_4.pdf

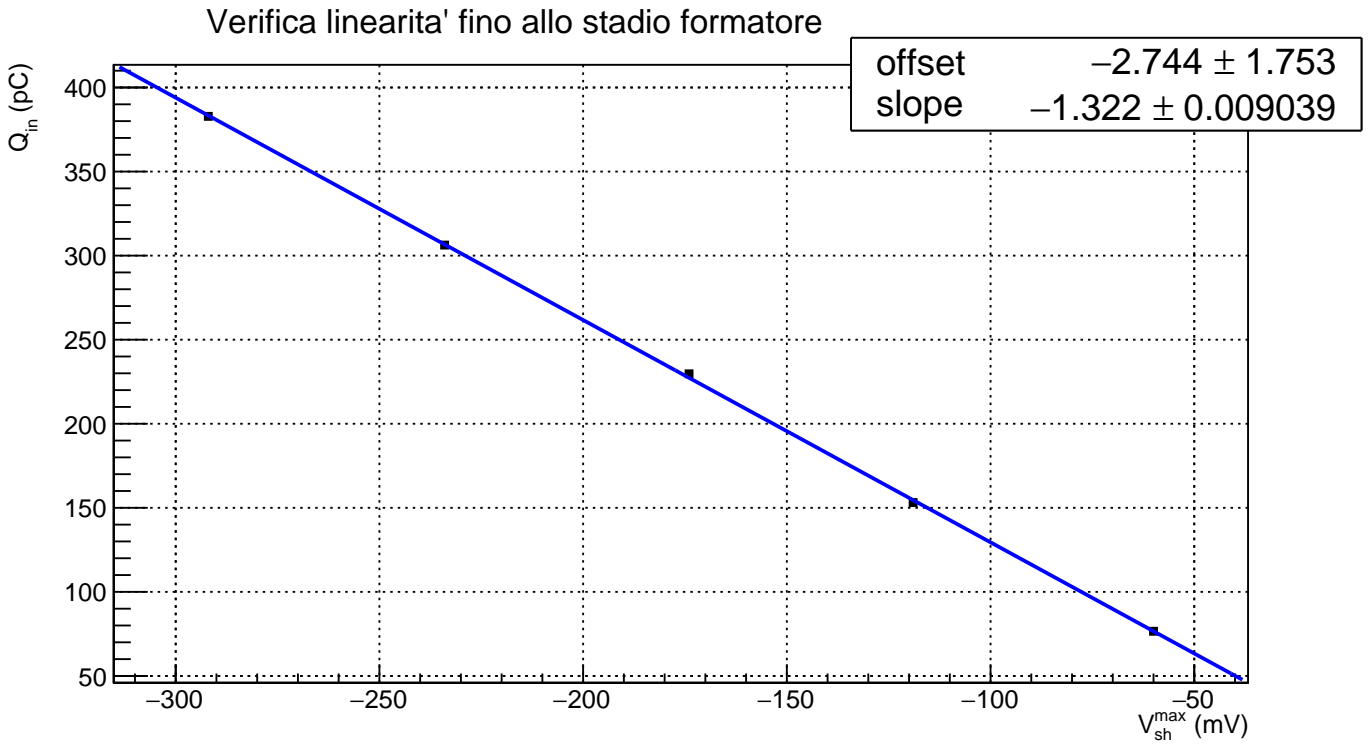
[picture p52: figure]
(mV) max Vsh; offset; slope

Verifica linearita' fino allo stadio formatore
