aidinattar/RelazioneCatenaElettronica/logbook/3_1.pdf

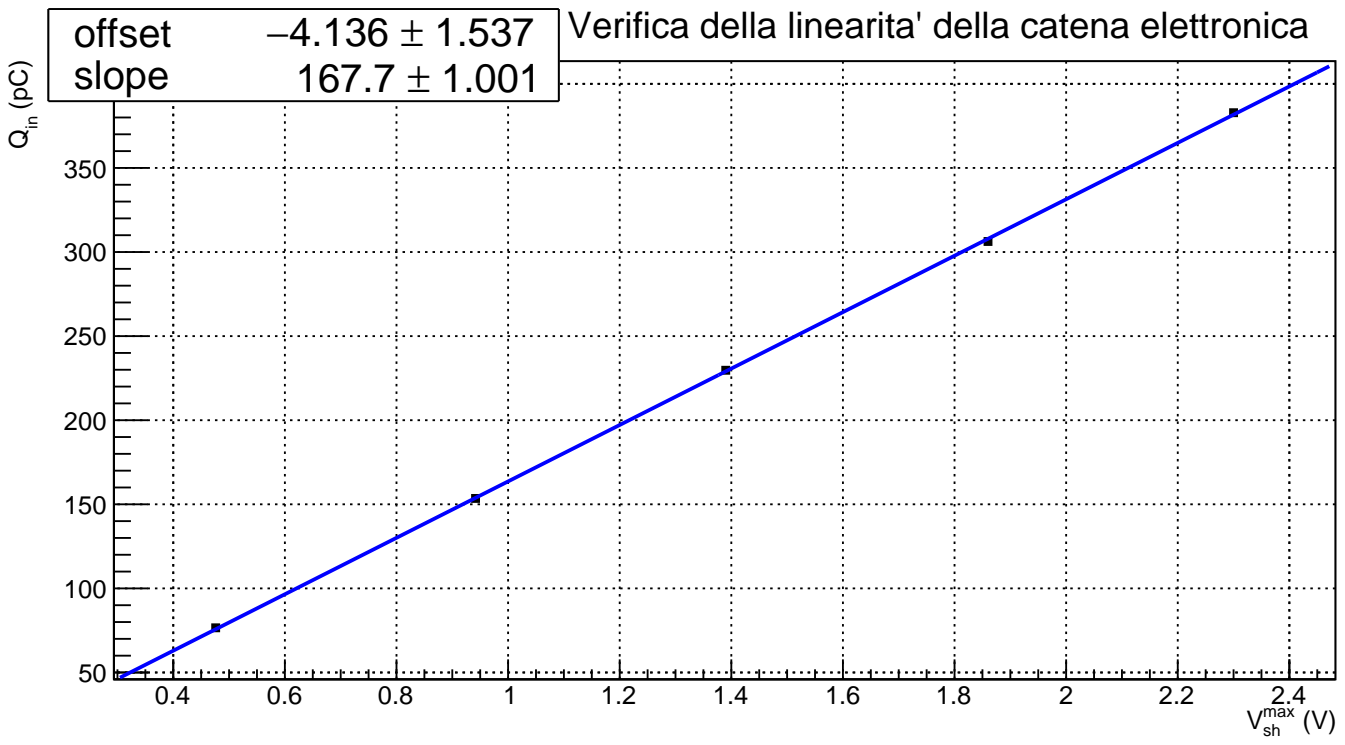
[picture p53: figure]
(V) max Vsh; offset; slope

Verifica della linearita' della catena elettronica
