aidinattar/RelazioneCatenaElettronica/logbook/3_2.pdf

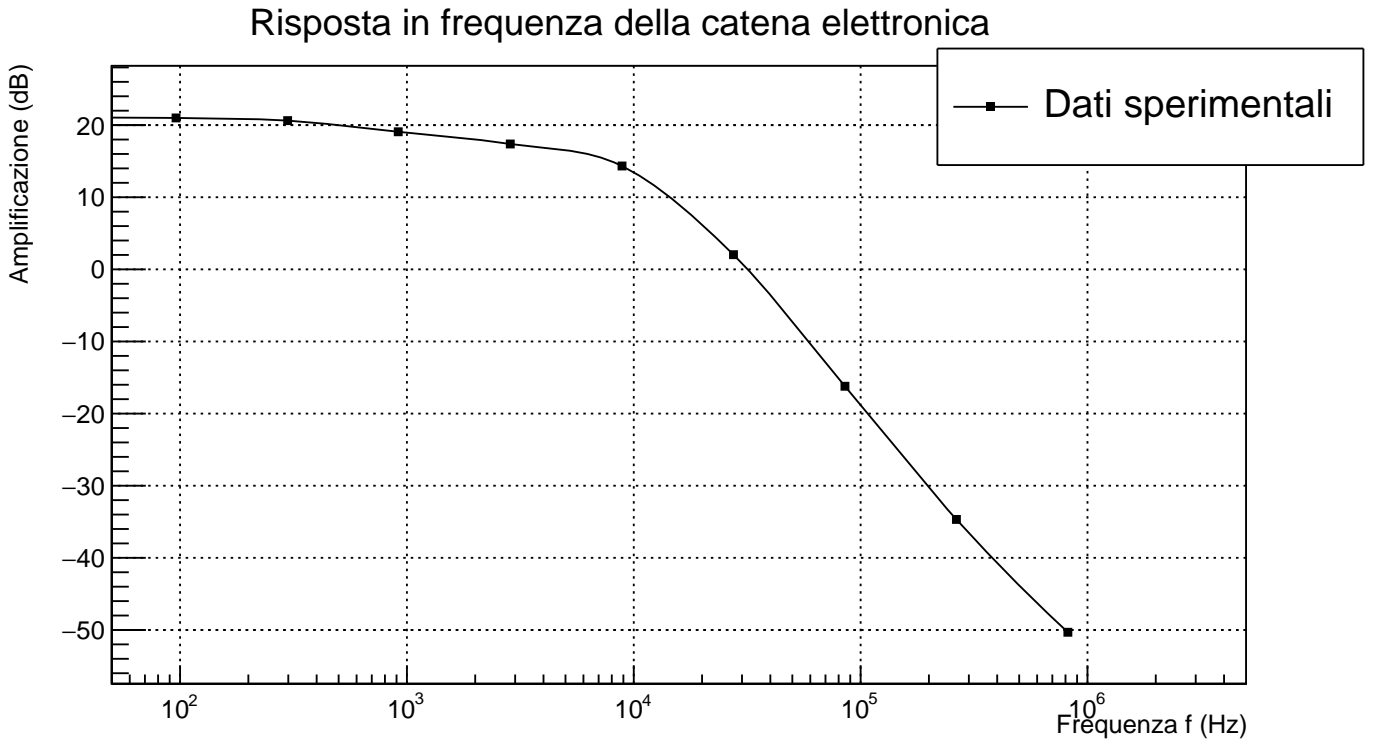
[picture p54: figure]
Amplificazione (dB) Dati sperimentali

2 10 | 3 10 | 4 10 | 5 10 | 6 10 Frequenza f (Hz) −50 −40 −30 −20 −10

## Risposta in frequenza della catena elettronica
