aidinattar/RelazioneCatenaElettronica/4_1.pdf

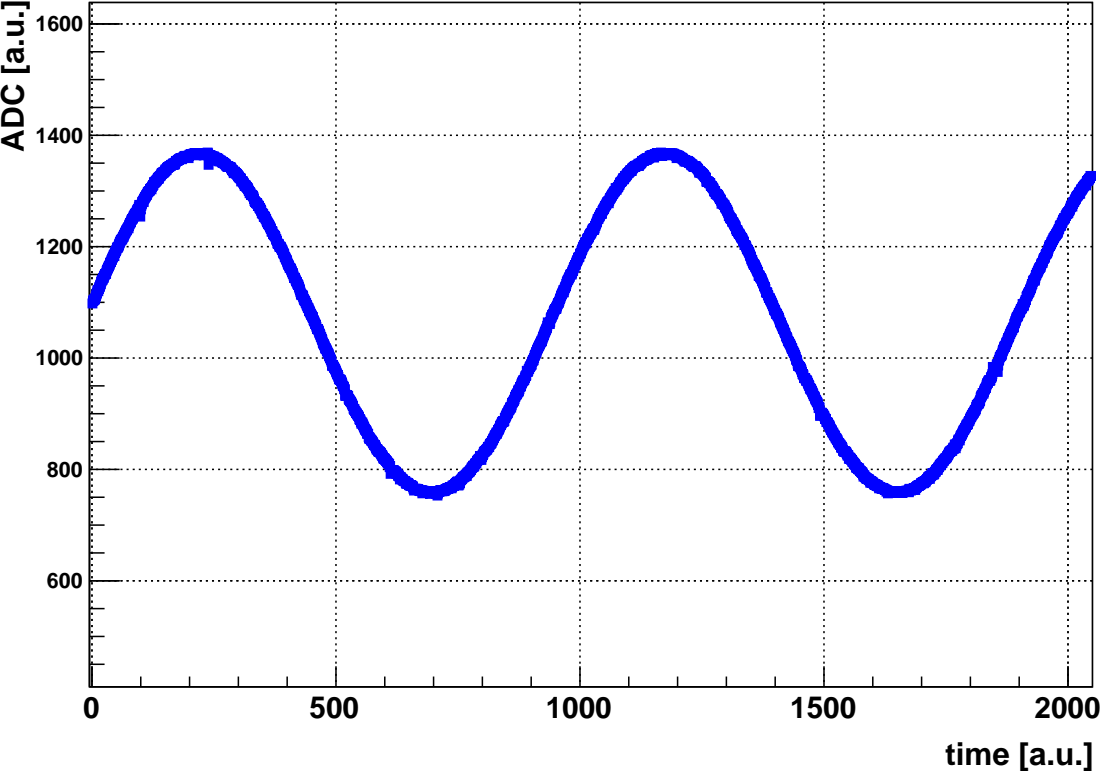
[picture p55: page 1]
time [a.u.]; ADC [a.u.]
