aidinattar/RelazioneCatenaElettronica/4_2.pdf

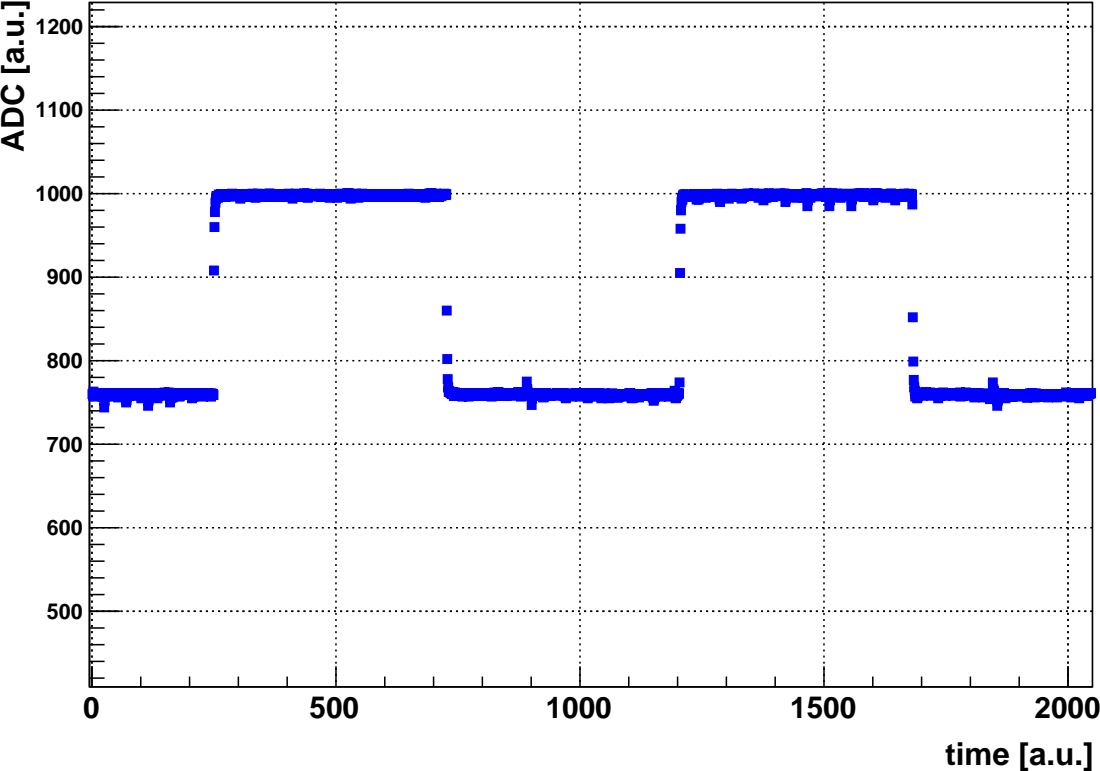
[picture p56: page 1]
time [a.u.]; ADC [a.u.]
