aidinattar/RelazioneCatenaElettronica/arduino10.pdf

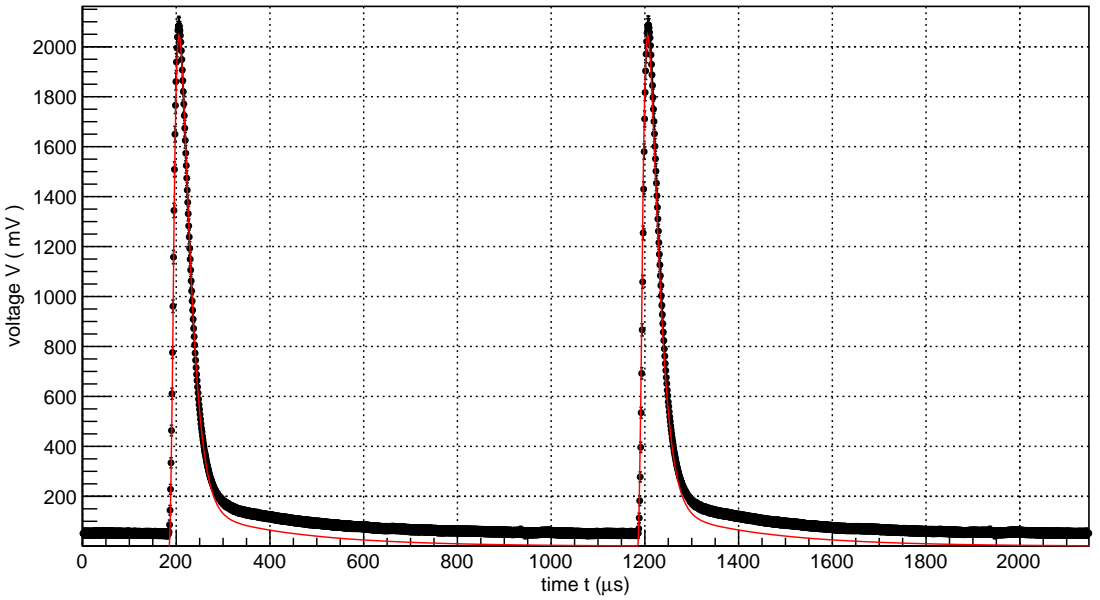
[picture p57: page 1]
time t (µs); voltage V ( mV )
