aidinattar/RelazioneCatenaElettronica/arduino2.pdf

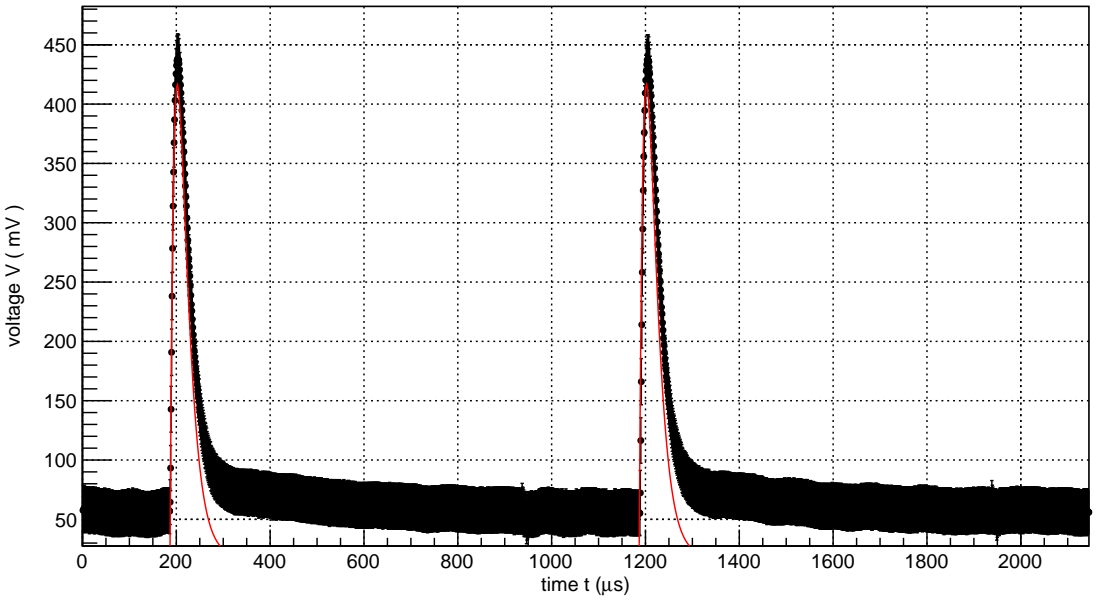
[picture p58: page 1]
time t (µs); voltage V ( mV )
