aidinattar/RelazioneCatenaElettronica/calibverticale.pdf

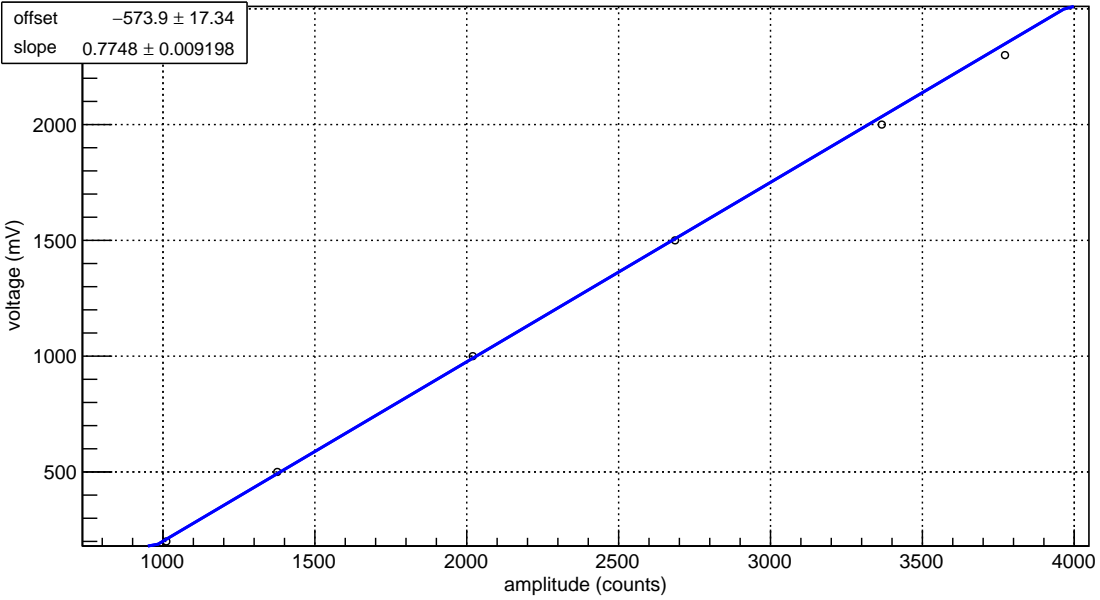
[picture p59: page 1]
amplitude (counts); voltage (mV)

2500 offset offset slope slope
−573.9 ± 17.34 −573.9 ± 17.34 0.7748 ± 0.009198 0.7748 ± 0.009198
