aidinattar/RelazioneCatenaElettronica/forma_no_pz.pdf

| Experimental data method fit ⁽²⁾ χ
| Spice simulation

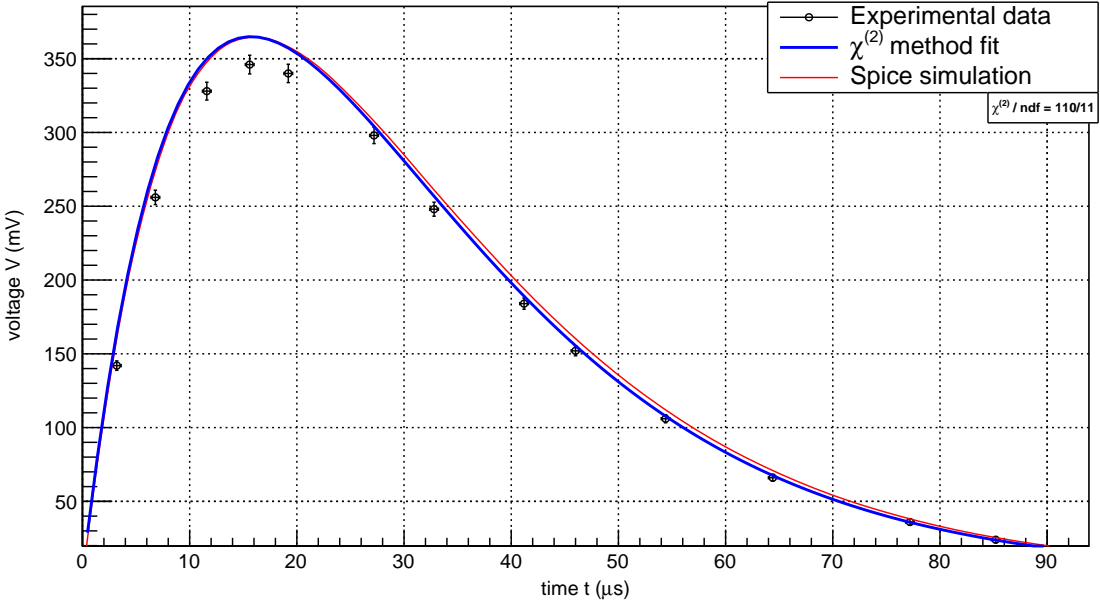
[picture p60: page 1]
time t (µs); voltage V (mV)

/ ndf = 110/11 ⁽²⁾ χ
