aidinattar/RelazioneCatenaElettronica/alimentazione.pdf

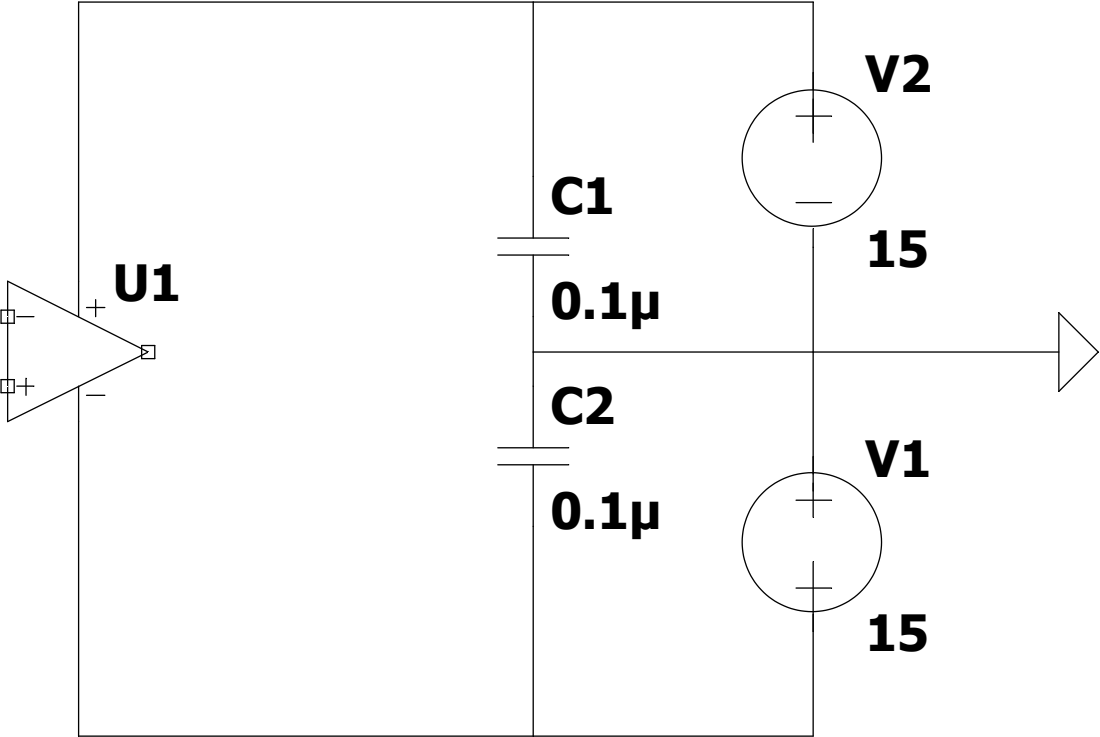
[picture p61: page 1]
