aidinattar/RelazioneCatenaElettronica/preamp.pdf

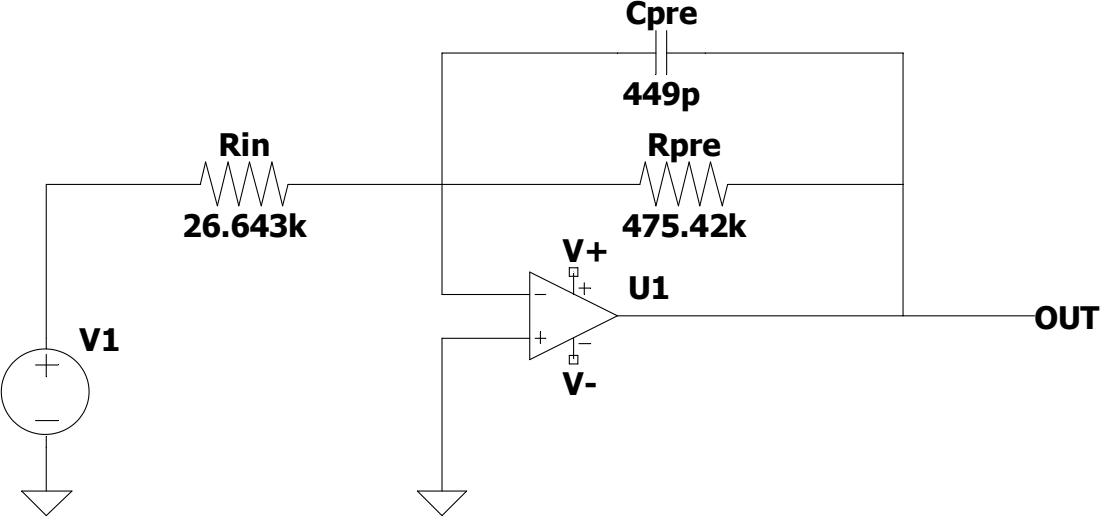
[picture p62: page 1]
Cpre; 449p Rpre; Rin; OUT
