aidinattar/RelazioneCatenaElettronica/shapercomp.pdf

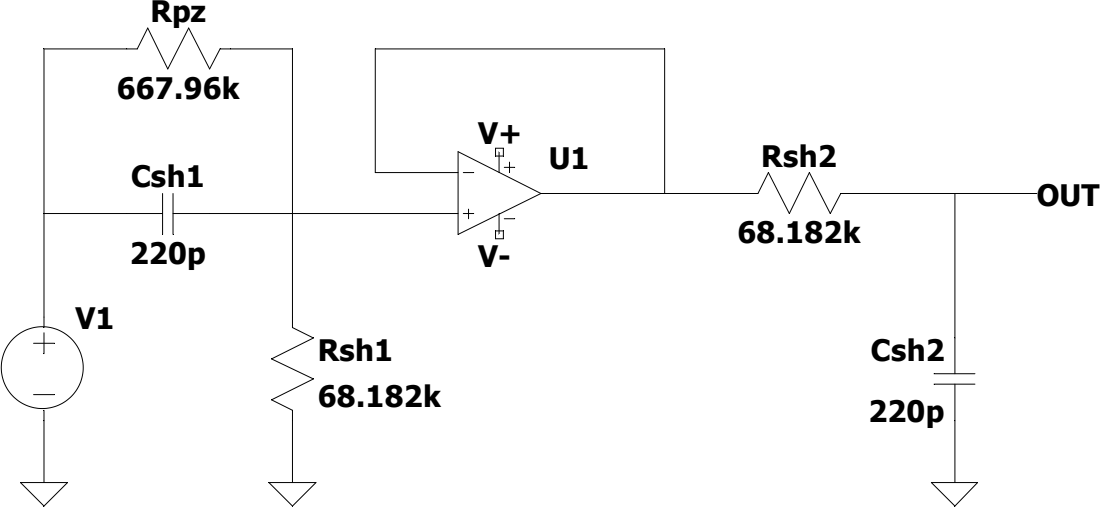
[picture p63: page 1]
Csh1; Csh2; Rsh1 68.182k; Rsh2; Rpz; OUT
