aidinattar/RelazioneCatenaElettronica/bodecatena.pdf

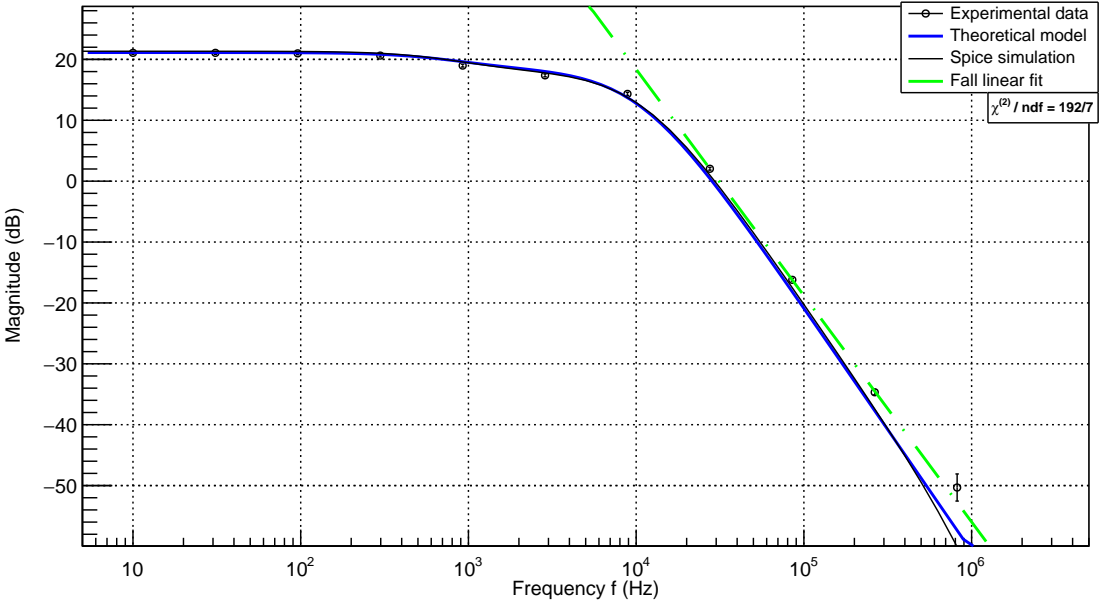
[picture p64: page 1]
Frequency f (Hz) −50 −40 −30 −20 −10; Magnitude (dB)

Experimental data Theoretical model Spice simulation

Fall linear fit
/ ndf = 192/7 ⁽²⁾ χ
