aidinattar/RelazioneCatenaElettronica/bodepreamp.pdf

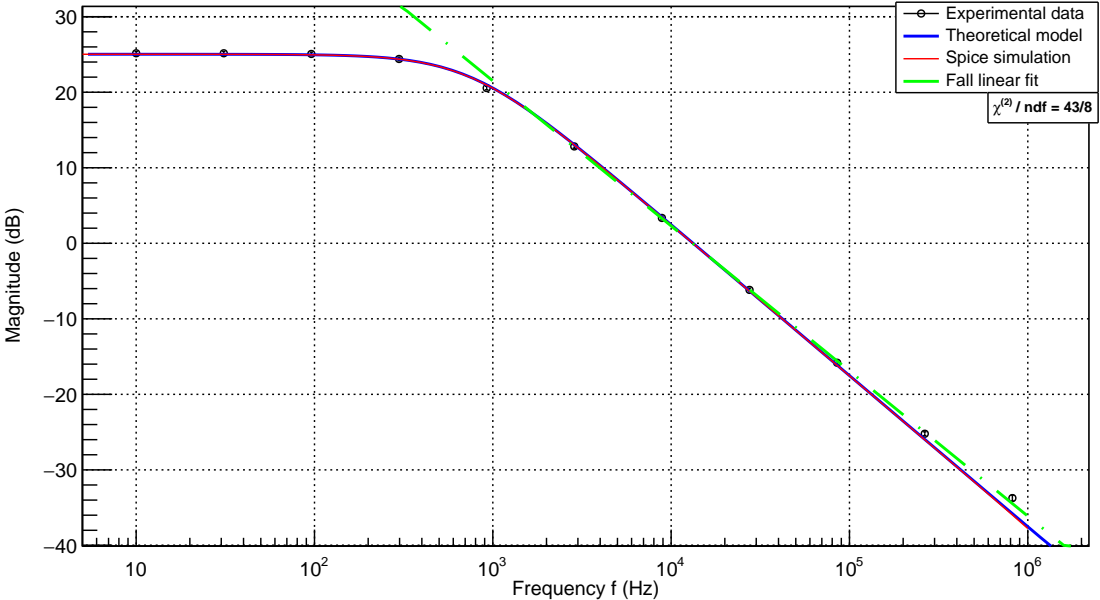
[picture p65: page 1]
Frequency f (Hz) −40 −30 −20 −10; Magnitude (dB)

Experimental data
Theoretical model Spice simulation Fall linear fit

/ ndf = 43/8 ⁽²⁾ χ
