aidinattar/RelazioneCatenaElettronica/bodeshaper_no_pz.pdf

## Frequency f (Hz) −40 −35 −30 −25 −20 −15 −10−5

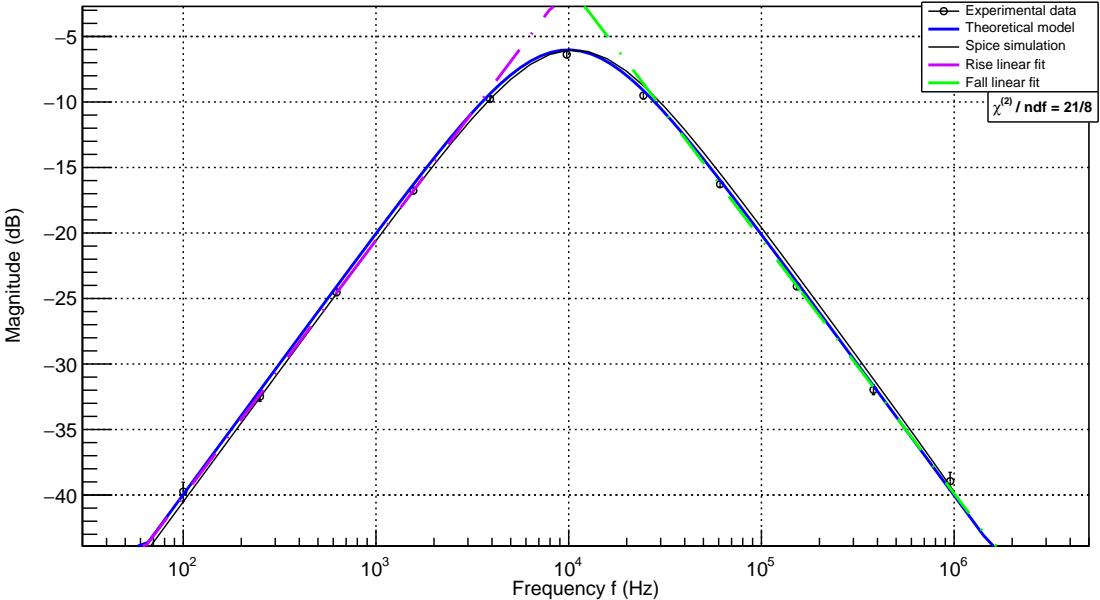
[picture p66: page 1]
Magnitude (dB)

Experimental data Theoretical model

Spice simulation Rise linear fit Fall linear fit

/ ndf = 21/8 ⁽²⁾ χ
