aidinattar/RelazioneCatenaElettronica/chi_forma_no_pz_no_chi.pdf

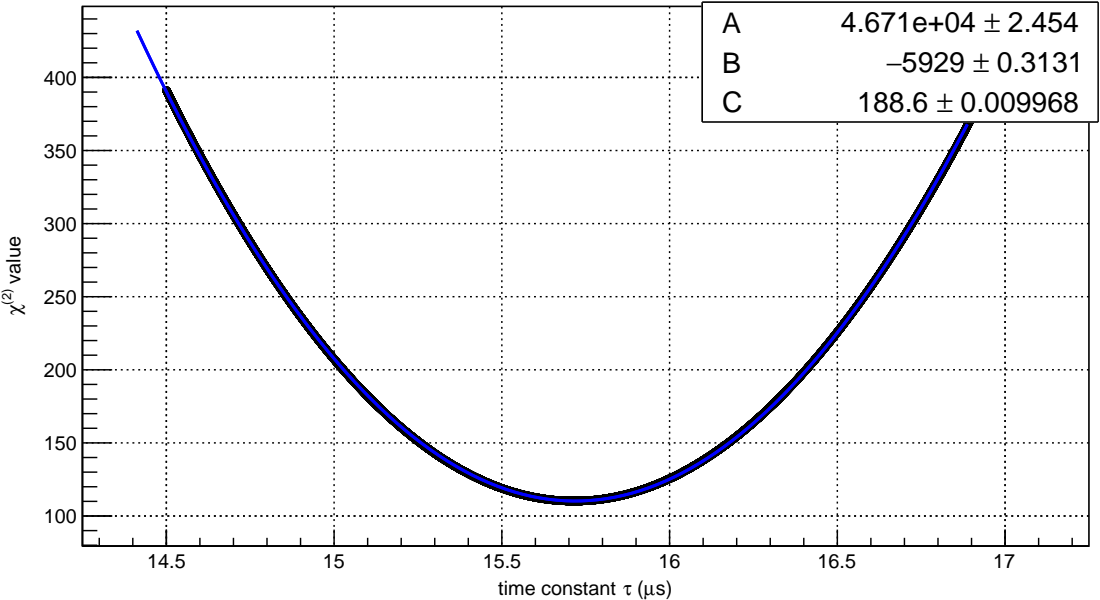
[picture p67: page 1]
value

time constant τ (µs)
