aidinattar/RelazioneCatenaElettronica/preampRC.pdf

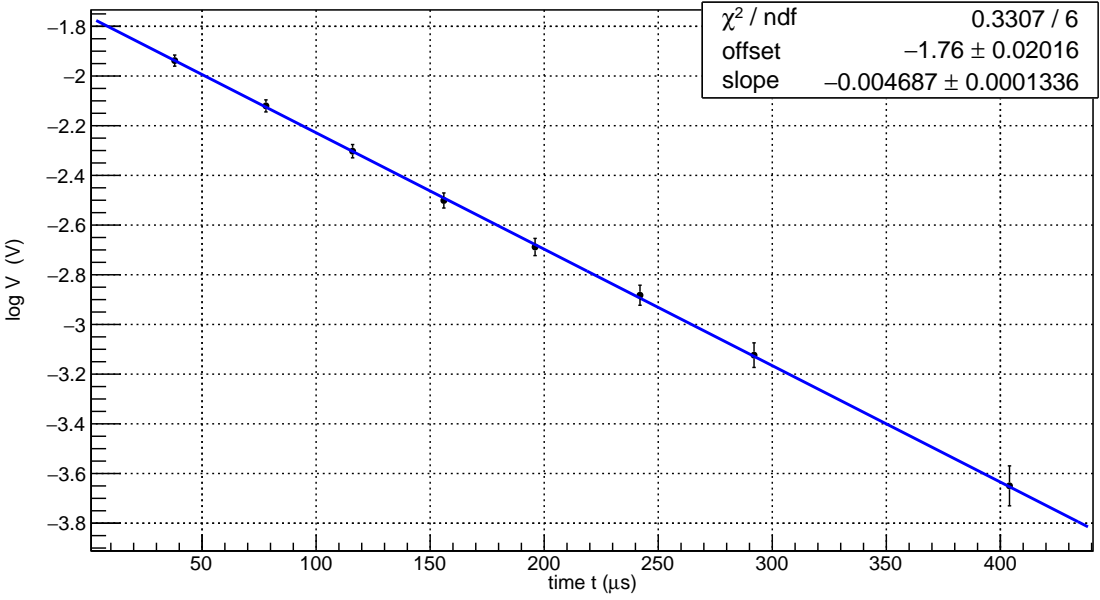
[picture p68: page 1]
time t (µs) −3.8 −3.6 −3.4 −3.2−3 −2.8 −2.6 −2.4 −2.2−2 −1.8; log V (V)

/ ndf ² χ | | 0.3307 / 6
offset | | −1.76 ± 0.02016
slope | −0.004687 ± 0.0001336
