aidinattar/RelazioneCatenaElettronica/catenaQvsV.pdf

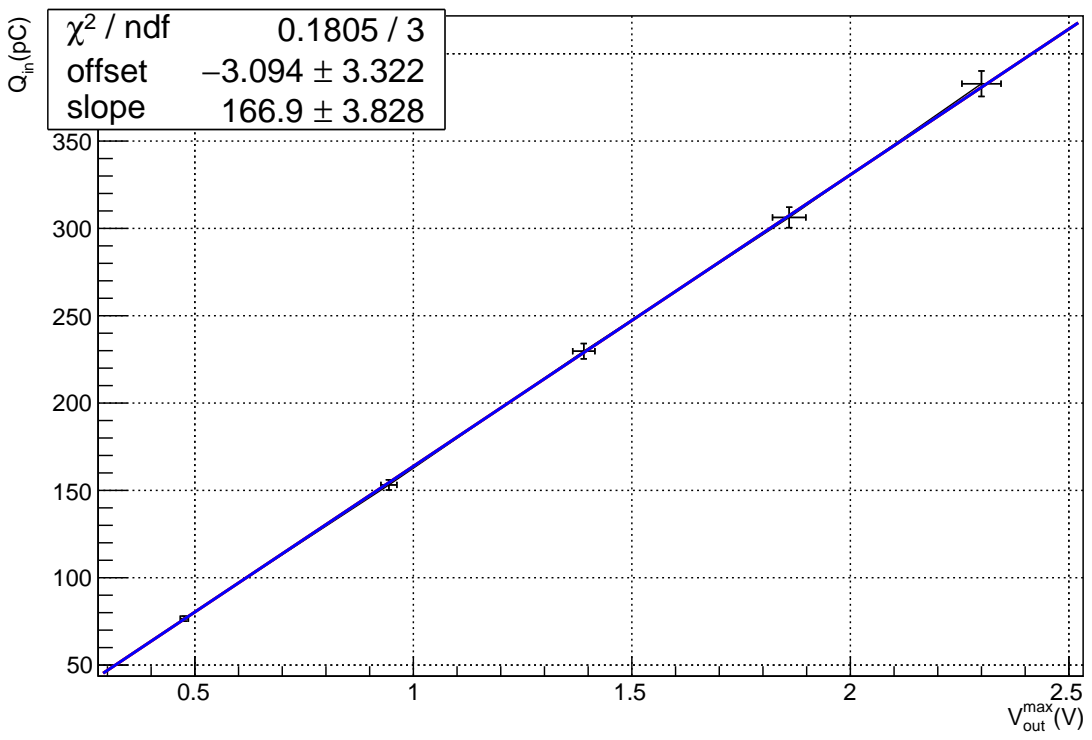
[picture p69: page 1]
(V) max Vout; offset; slope

/ ndf ² χ / ndf ² χ
