aidinattar/RelazioneCatenaElettronica/2.asc

C1: cap; 220p
C2: cap; 220p
C3: cap; 0.1µ
C4: cap; 0.1µ
R1: res; 68.182k
R2: res; 68.182k
U1: UniversalOpamp2; Avol=0.1Meg GBW=4Meg Slew=13Meg
V1: voltage; PULSE(0 1 0 1n 1n 5m 10m 100); AC 1 0
V2: voltage; 15
V3: voltage; 15
Named nets: 0
.tran 200u
OUT
;ac dec 10 10 1000000
