aidinattar/RelazioneCatenaElettronica/1.asc

C1: cap; 449p
C2: cap; 0.1µ
C3: cap; 0.1µ
R3: res2; 475.42k
R4: res2; 26.643k
U1: UniversalOpamp2; Avol=0.1Meg GBW=4Meg Slew=13Meg
V1: voltage; PULSE(0 1.06 0 1n 1n 2u 2m 100); AC 1 0
V2: voltage; 15
V3: voltage; 15
Named nets: 0
OUT
.tran 1m
;ac dec 10 1 1000000
