aidinattar/RelazioneCatenaElettronica/4.asc

C1: cap; 449p
C2: cap; 0.1µ
C3: cap; 0.1µ
C4: cap; 220p
C5: cap; 220p
C6: cap; 0.1µ
C7: cap; 0.1µ
C8: cap; 0.1µ
C9: cap; 0.1µ
C10: cap; 0.1µ
C11: cap; 0.1µ
R1: res2; 475.42k
R1a: res; 5k
R2: res2; 26.643k
R2a: res; 13k
R3: res; 68.182k
R3a: res; 5k
R4: res; 68.182k
R4a: res; 7.5k
R5: res; 665.588k
U1: UniversalOpamp2; Avol=0.1Meg GBW=4Meg Slew=13Meg
U2: UniversalOpamp2; Avol=0.1Meg GBW=4Meg Slew=13Meg
U3: UniversalOpamp2; Avol=0.1Meg GBW=4Meg Slew=13Meg
U4: UniversalOpamp2; Avol=0.1Meg GBW=4Meg Slew=13Meg
V1: voltage; 15
V2: voltage; 15
V3: voltage; PULSE(0 1.06 0 1n 1n 10u 2m 100); AC 1 0
V4: voltage; 15
V5: voltage; 15
V6: voltage; 15
V7: voltage; 15
V8: voltage; 15
V9: voltage; 15
Named nets: 0
;tran 1m
.ac dec 10 1 1000000
OUT
