aidinattar/RelazioneCatenaElettronica/(commit log)

2019-12-04 aggiunto files di simulazione, il 2.asc lo sto finendo
2019-12-04 file di dati punto 1.4
2019-12-04 aggiunto tutti i circuiti simulati
2019-12-05 ho eliminato i file di log di qualcuno, in modo SCOCCIATOgit status comunque peace
2019-12-05 Aggiunto anche i plot di arduino che avevo dimenticato. peace
2019-12-05 Aggiunto la griglia in un plot. peace
2019-12-16 aggiunto i dati
    [dati.ods]
2019-12-16 aggiunto file con analisi dati del preamp
    [datiANALISI.ods]
2019-12-16 trattazione completa degli errori
    [dati.ods]
2019-12-17 file excel corretto
    [dati.ods]
2019-12-17 aggiunto i fit, ho risolto il problema di bode e domani aggiungerò anche i grafici di bode. peace
2019-12-18 aggiunto grafici di bode. peace
2019-12-18 relazione, modifica dati su excel
    [dati.ods]
2019-12-18 relazione e immagini circuiti in pdf
2019-12-18 aggiunto file di fit
2019-12-18 relazione nuova + grafici preamp RC e grafico shaper compensato
    [dati.ods]
2019-12-18 tradotto i grafici di bode. peace
2019-12-19 aggiunto i parametri di interpolazione + messo i chi quadri nei bode
2019-12-19 aggiunto file con periodi arduino
2019-12-19 aggiunto grafici per la forma d'onda dello shaper.
2019-12-19 aggiunto grafico della forma d'onda dello shaper non compensato in cui mancava la simulazione. peace
2019-12-19 relazione + prova grafici calibrazione temporale
    [dati.ods]
2019-12-20 relazione nuova
    [dati.ods]
2020-01-14 varie aggiunte di grafici e commenti, da fare ancora la parte di arduino che mi sta mettendo in difficoltà
2020-01-15 finito l'analisi di arduino: da aggiungere alla relazione + conclusioni. peace
2020-01-15 relazione finale di champions league
2020-01-17 relazione finale di europa league
2020-01-19 relazione finale di mitropa cup
2020-01-19 tolto spazi dopo immagini, cambiato ultime tabelle arduino perche' troppo larghe e aggiunto frase su chi quadro in appendice
2020-01-19 aggiunto frase per dire il motivo per cui non mettiamo tutti i grafici nella calibrazione
